antmicro/oculink-10gbe-adapter/2xrj45.kicad_sch

## KiCad design 2xrj45.kicad_sch (2026-02-23, an earlier design)

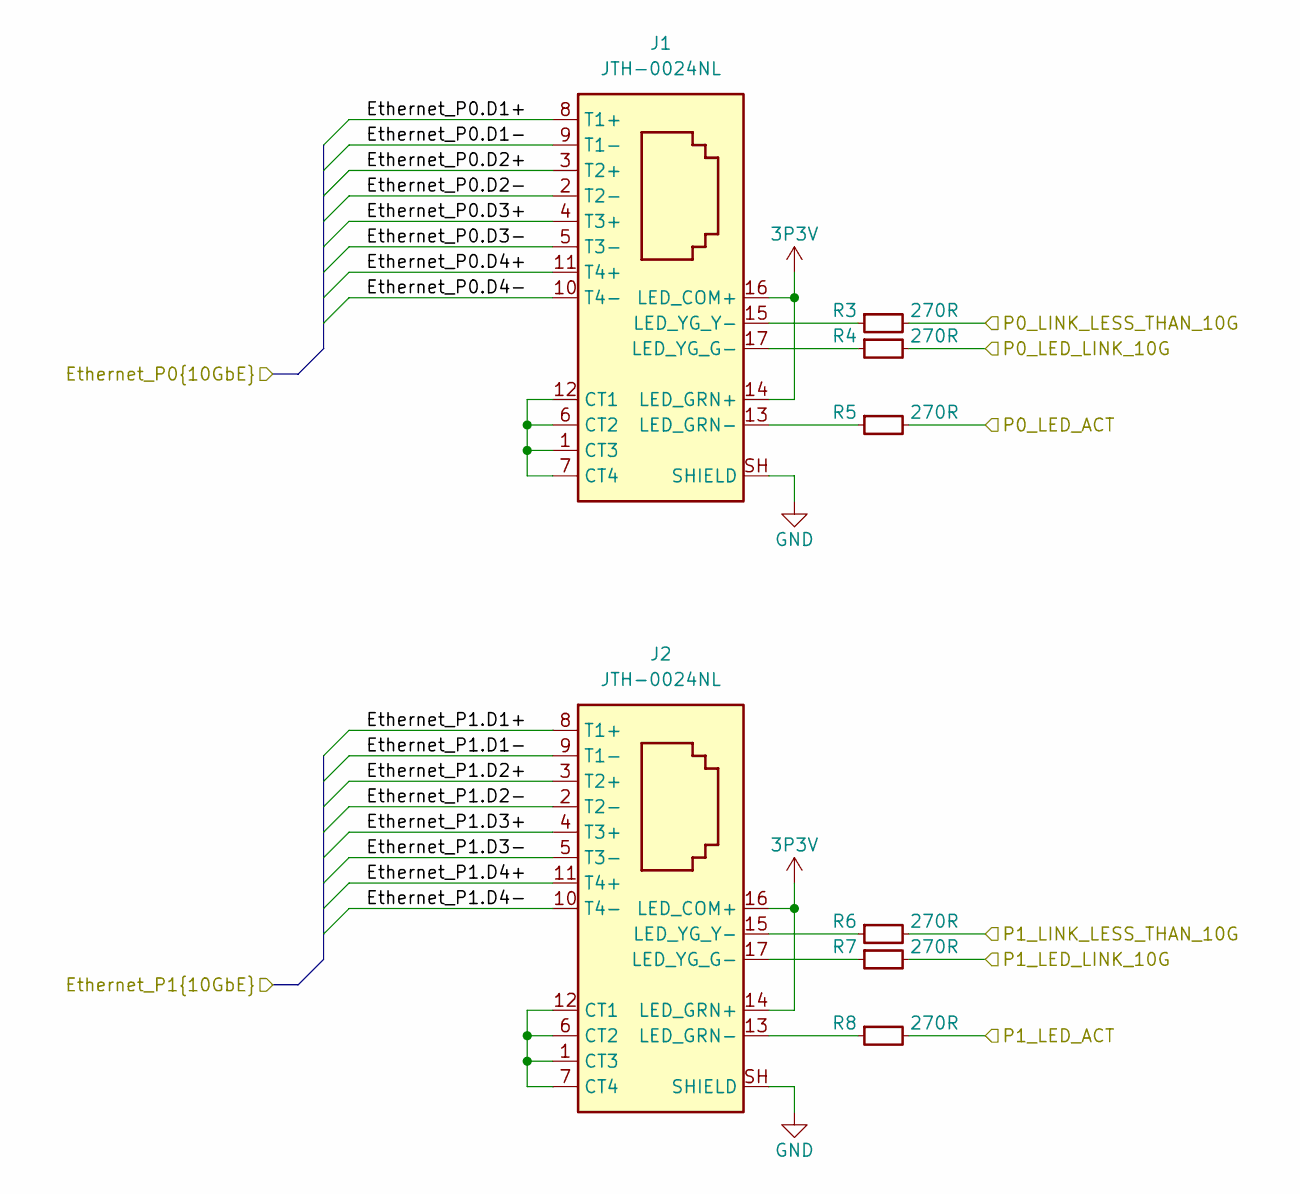
[picture p1: schematic 2xrj45.kicad_sch]

Parts:
J1, J2: Bus_RJ45_JTH-0024NL; RJ45_JTH-0024NL; MPN JTH-0024NL
R3, R4, R5, R6, R7, R8: R_270R_0402; R_0402_1005Metric; Tolerance 1%; MPN CR0402-FX-2700GLF

Connections:
3P3V: J1.14 (LED_GRN+), J1.16 (LED_COM+), J2.14 (LED_GRN+), J2.16 (LED_COM+)
Ethernet_P0.D1+: J1.8 (T1+)
Ethernet_P0.D1-: J1.9 (T1-)
Ethernet_P0.D2+: J1.3 (T2+)
Ethernet_P0.D2-: J1.2 (T2-)
Ethernet_P0.D3+: J1.4 (T3+)
Ethernet_P0.D3-: J1.5 (T3-)
Ethernet_P0.D4+: J1.11 (T4+)
Ethernet_P0.D4-: J1.10 (T4-)
Ethernet_P1.D1+: J2.8 (T1+)
Ethernet_P1.D1-: J2.9 (T1-)
Ethernet_P1.D2+: J2.3 (T2+)
Ethernet_P1.D2-: J2.2 (T2-)
Ethernet_P1.D3+: J2.4 (T3+)
Ethernet_P1.D3-: J2.5 (T3-)
Ethernet_P1.D4+: J2.11 (T4+)
Ethernet_P1.D4-: J2.10 (T4-)
GND: J1.SH (SHIELD), J2.SH (SHIELD)
unnamed: J1.1 (CT3), J1.6 (CT2), J1.7 (CT4), J1.12 (CT1)
unnamed: J1.13 (LED_GRN-), R5.1
unnamed: J1.15 (LED_YG_Y-), R3.1
unnamed: J1.17 (LED_YG_G-), R4.1
unnamed: J2.1 (CT3), J2.6 (CT2), J2.7 (CT4), J2.12 (CT1)
unnamed: J2.13 (LED_GRN-), R8.1
unnamed: J2.15 (LED_YG_Y-), R6.1
unnamed: J2.17 (LED_YG_G-), R7.1
P0_LED_ACT: R5.2
P0_LED_LINK_10G: R4.2
P0_LINK_LESS_THAN_10G: R3.2
P1_LED_ACT: R8.2
P1_LED_LINK_10G: R7.2
P1_LINK_LESS_THAN_10G: R6.2
