antmicro/oculink-10gbe-adapter/fan-controller.kicad_sch

## KiCad design fan-controller.kicad_sch (2026-02-23, an earlier design)

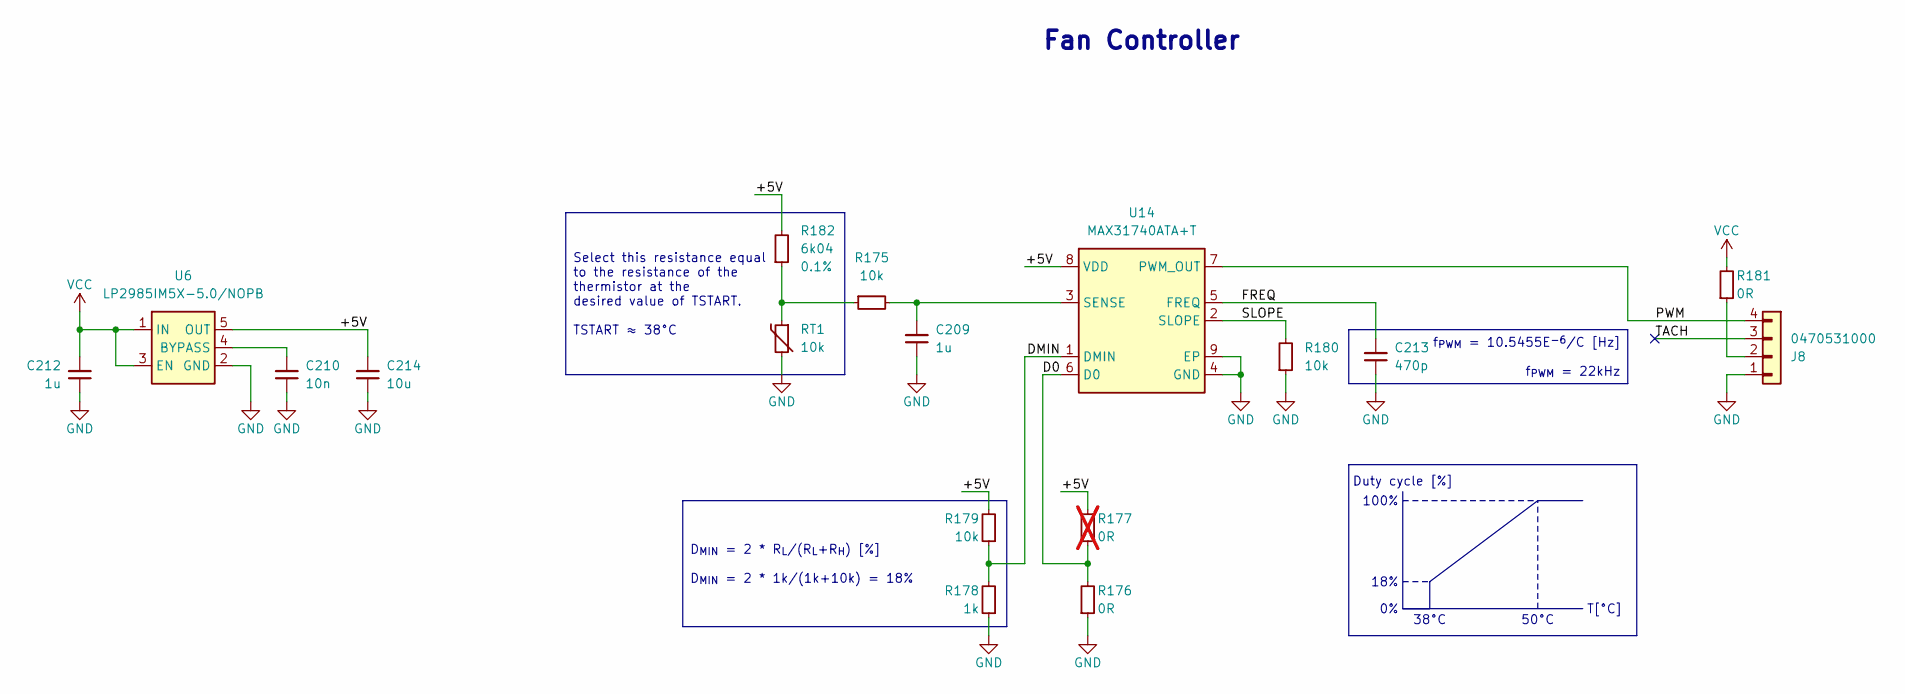
[picture p2: schematic fan-controller.kicad_sch]

Parts:
C209: C_1u_0402; C_0402_1005Metric; MPN C1005X6S1A105K050BC
C210: C_10n_0402; C_0402_1005Metric; Voltage 50V; MPN GRM155R71H103KA88D
C212: C_1u_16V_X7R_0603; C_0603_1608Metric; Voltage 16V; MPN C0603C105K4RAC7411
C213: C_470p_0402; C_0402_1005Metric; Voltage 25V; MPN 0402B471K250CT
C214: C_10u_10V_X7R_0603; C_0603_1608Metric; Voltage 10V; MPN GRM188Z71A106KA73D
J8: Molex_KK_1x4_0470531000; Conn_Molex_KK_1x4_0470531000; MPN 0470531000
R175, R179, R180: R_10k_0402; R_0402_1005Metric; Tolerance 1%; MPN CR0402-FX-1002GLF
R176, R181: R_0R_0402; R_0402_1005Metric; MPN ERJ2GE0R00X
R177: R_0R_0402; R_0402_1005Metric; MPN ERJ2GE0R00X; not fitted
R178: R_1k_0402; R_0402_1005Metric; Tolerance 1%; MPN CR0402-FX-1001GLF
R182: R_6k04_0.1%_0402; R_0402_1005Metric; Tolerance 0.1%; MPN TNPW04026K04BEED
RT1: RT_NTC_10k_0603; R_0603_1608Metric; Voltage 5V; MPN NCP15XH103F03RC
U6: LP2985IM5X-5.0_SOT; SOT-23-5; MPN LP2985IM5X-5.0/NOPB
U14: MAX31740ATA+T; TDFN-8-1EP_2x3x0.75mm_P0.5mm_EP1.75x1.63mm; MPN MAX31740ATA+T

Connections:
+5V: C214.2, R177.2, R179.2, R182.2, U6.5 (OUT), U14.8 (VDD)
D0: R176.2, R177.1, U14.6 (D0)
DMIN: R178.2, R179.1, U14.1 (DMIN)
FREQ: C213.2, U14.5 (FREQ)
GND: C209.1, C210.1, C212.1, C213.1, C214.1, J8.1, R176.1, R178.1, R180.1, RT1.2, U6.2 (GND), U14.4 (GND), U14.9 (EP)
unnamed: C209.2, R175.2, U14.3 (SENSE)
unnamed: C210.2, U6.4 (BYPASS)
unnamed: J8.2, R181.1
unnamed: R175.1, R182.1, RT1.1
PWM: J8.4, U14.7 (PWM_OUT)
SLOPE: R180.2, U14.2 (SLOPE)
TACH: J8.3
VCC: C212.2, R181.2, U6.1 (IN), U6.3 (EN)

Notes on the sheet:
Fan Controller
100%
Duty cycle [%]
T[°C]
38°C
50°C
18%
Select this resistance equal to the resistance of the thermistor at the desired value of TSTART. TSTART ≈ 38°C
D_{MIN} = 2 * R_{L}/(R_{L}+R_{H}) [%] D_{MIN} = 2 * 1k/(1k+10k) = 18%
f_{PWM} = 10.5455E^{-6}/C [Hz] f_{PWM} = 22kHz
