antmicro/oculink-10gbe-adapter/flash-memory.kicad_sch

## KiCad design flash-memory.kicad_sch (2026-02-23, an earlier design)

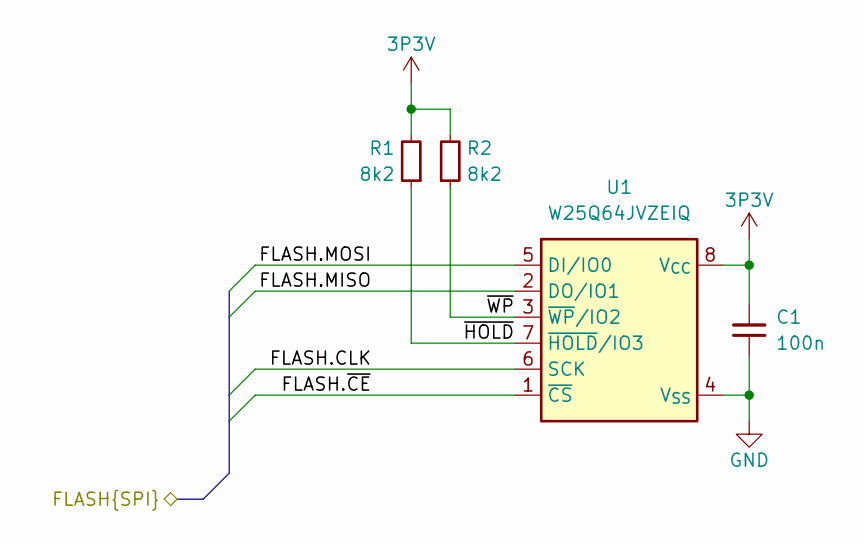
[picture p3: schematic flash-memory.kicad_sch]

Parts:
C1: C_100n_16V_X7R_0402; C_0402_1005Metric; Voltage 16V; MPN C0402C104J4RAC7411
R1, R2: R_8k2_0402; R_0402_1005Metric; Tolerance 1%; MPN CR0402-FX-8201GLF
U1: W25Q64JVZEIQ; WSON-8_6x8x0.5mm_P1.27mm; MPN W25Q64JVZEIQ

Connections:
3P3V: C1.2, R1.2, R2.2, U1.8 (V_{CC})
FLASH.CLK: U1.6 (SCK)
FLASH.MISO: U1.2 (DO/IO1)
FLASH.MOSI: U1.5 (DI/IO0)
FLASH.~CE: U1.1 (~CS)
GND: C1.1, U1.4 (V_{SS})
~HOLD: R1.1, U1.7 (~HOLD/IO3)
~WP: R2.1, U1.3 (~WP/IO2)
