antmicro/oculink-10gbe-adapter/ideal-diode.kicad_sch

## KiCad design ideal-diode.kicad_sch (2026-02-24, an earlier design)

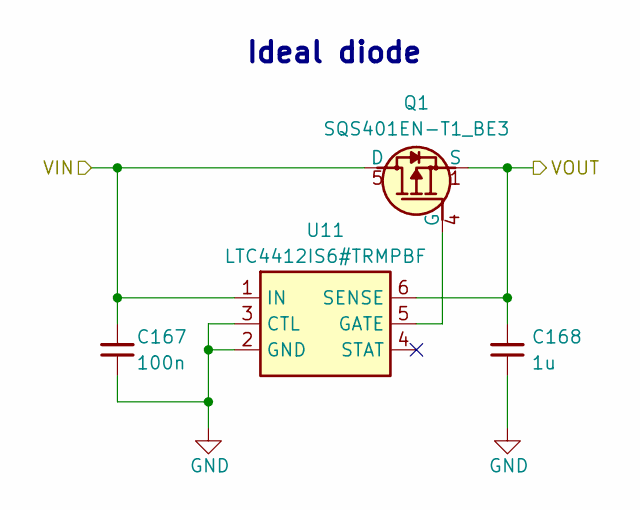
[picture p4: schematic ideal-diode.kicad_sch]

Parts:
C167: C_100n_0402; C_0402_1005Metric; Voltage 50V; MPN GRM155R61H104KE14D
C168: C_1u_25V_0402; C_0402_1005Metric; Voltage 25V; MPN GRM155R61E105KE11J
Q1: SQS401EN-T1_BE3; Vishay_PowerPAK_1212-8_Single; MPN SQS401EN-T1_BE3
U11: LTC4412IS6; SOT-23-6; MPN LTC4412IS6#TRMPBF

Connections:
GND: C167.1, C168.1, U11.2 (GND), U11.3 (CTL)
unnamed: Q1.4 (G), U11.5 (GATE)
VIN: C167.2, Q1.5 (D), U11.1 (IN)
VOUT: C168.2, Q1.1 (S), Q1.2 (S), Q1.3 (S), U11.6 (SENSE)

Notes on the sheet:
Ideal diode
