antmicro/oculink-10gbe-adapter/oculink-to-10gbe-adapter.kicad_sch

## KiCad design oculink-to-10gbe-adapter.kicad_sch (2026-02-23, an earlier design)

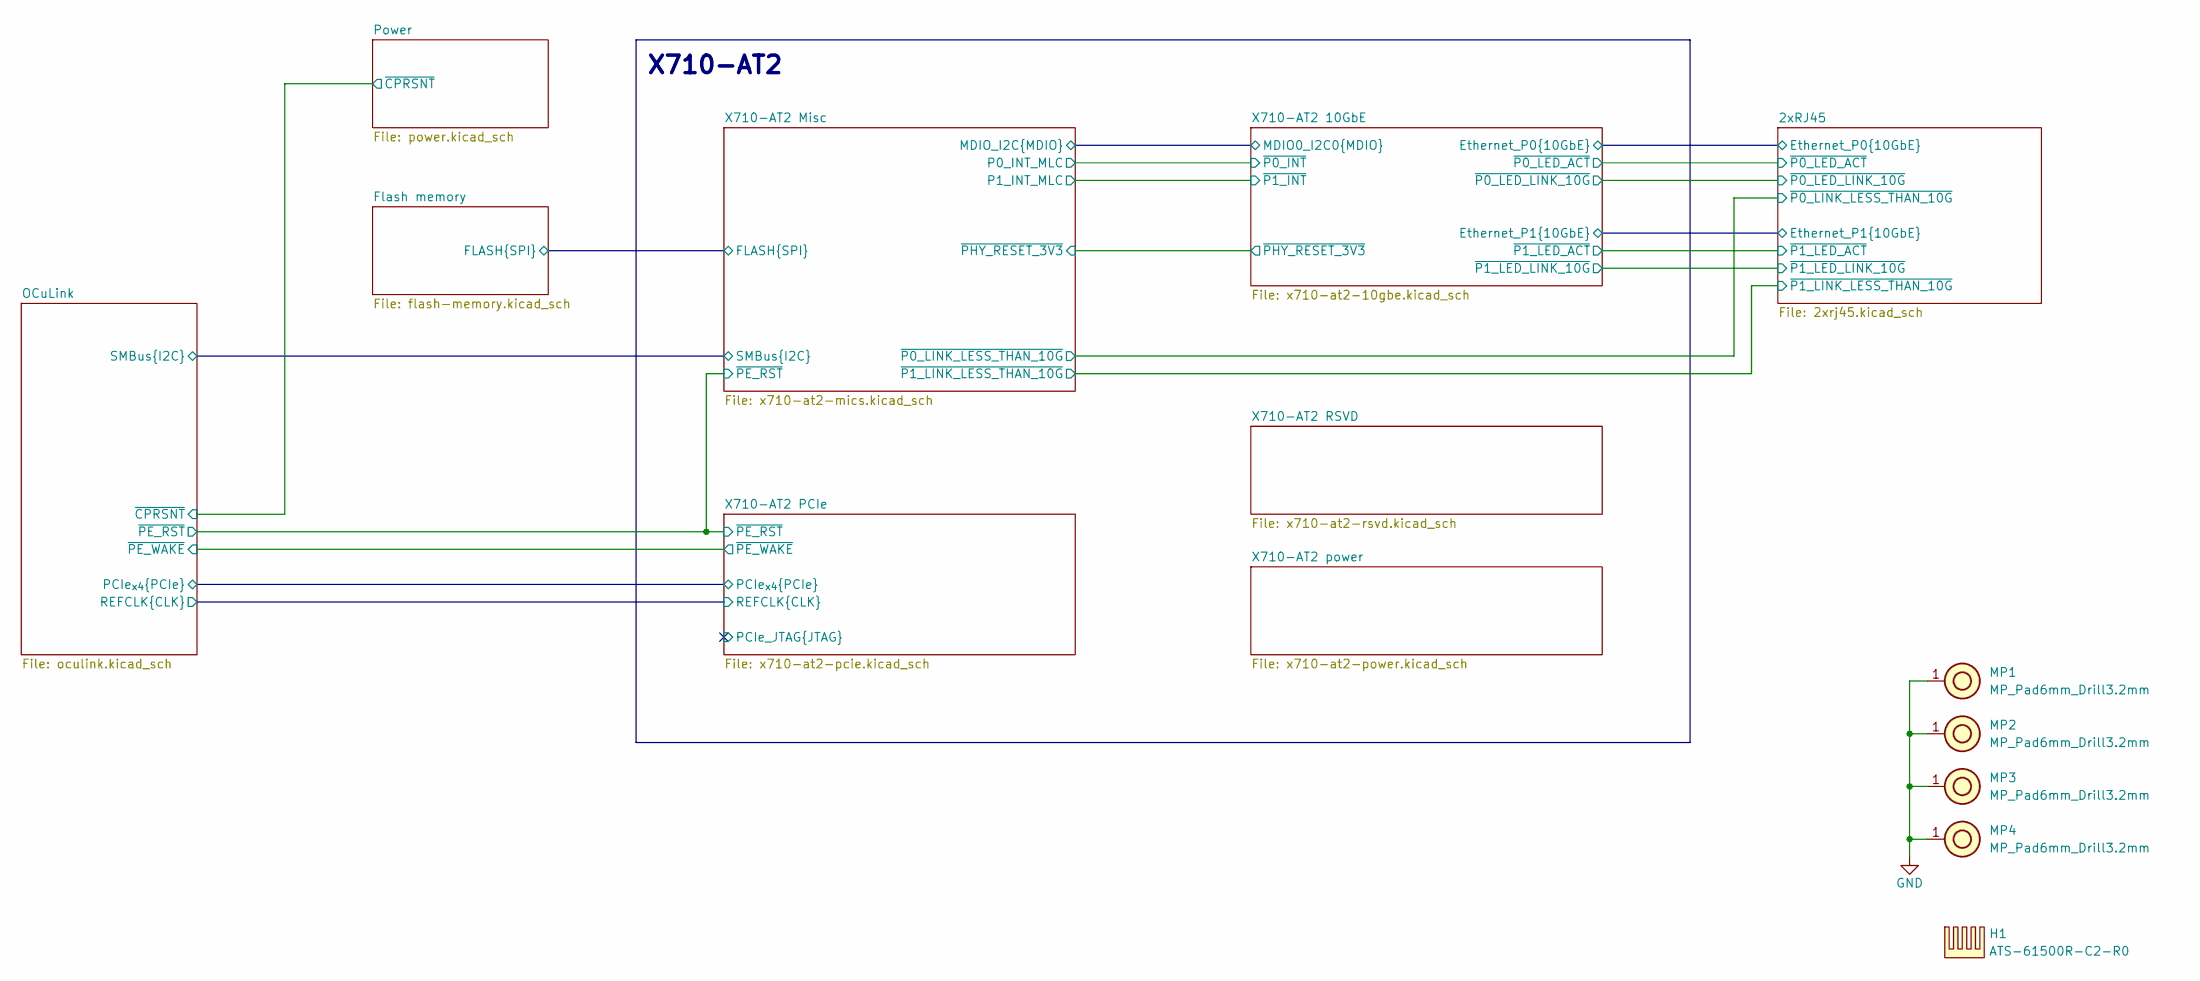
[picture p5: schematic oculink-to-10gbe-adapter.kicad_sch]

Parts:
H1: Heatsink_ATS-61500R-C2-R0; MPN ATS-61500R-C2-R0
MP1, MP2, MP3, MP4: MP_Pad6mm_Drill3.2mm

Connections:
GND: MP1.1, MP2.1, MP3.1, MP4.1

Notes on the sheet:
X710-AT2
