antmicro/oculink-10gbe-adapter/oculink.kicad_sch

## KiCad design oculink.kicad_sch (2026-02-23, an earlier design)

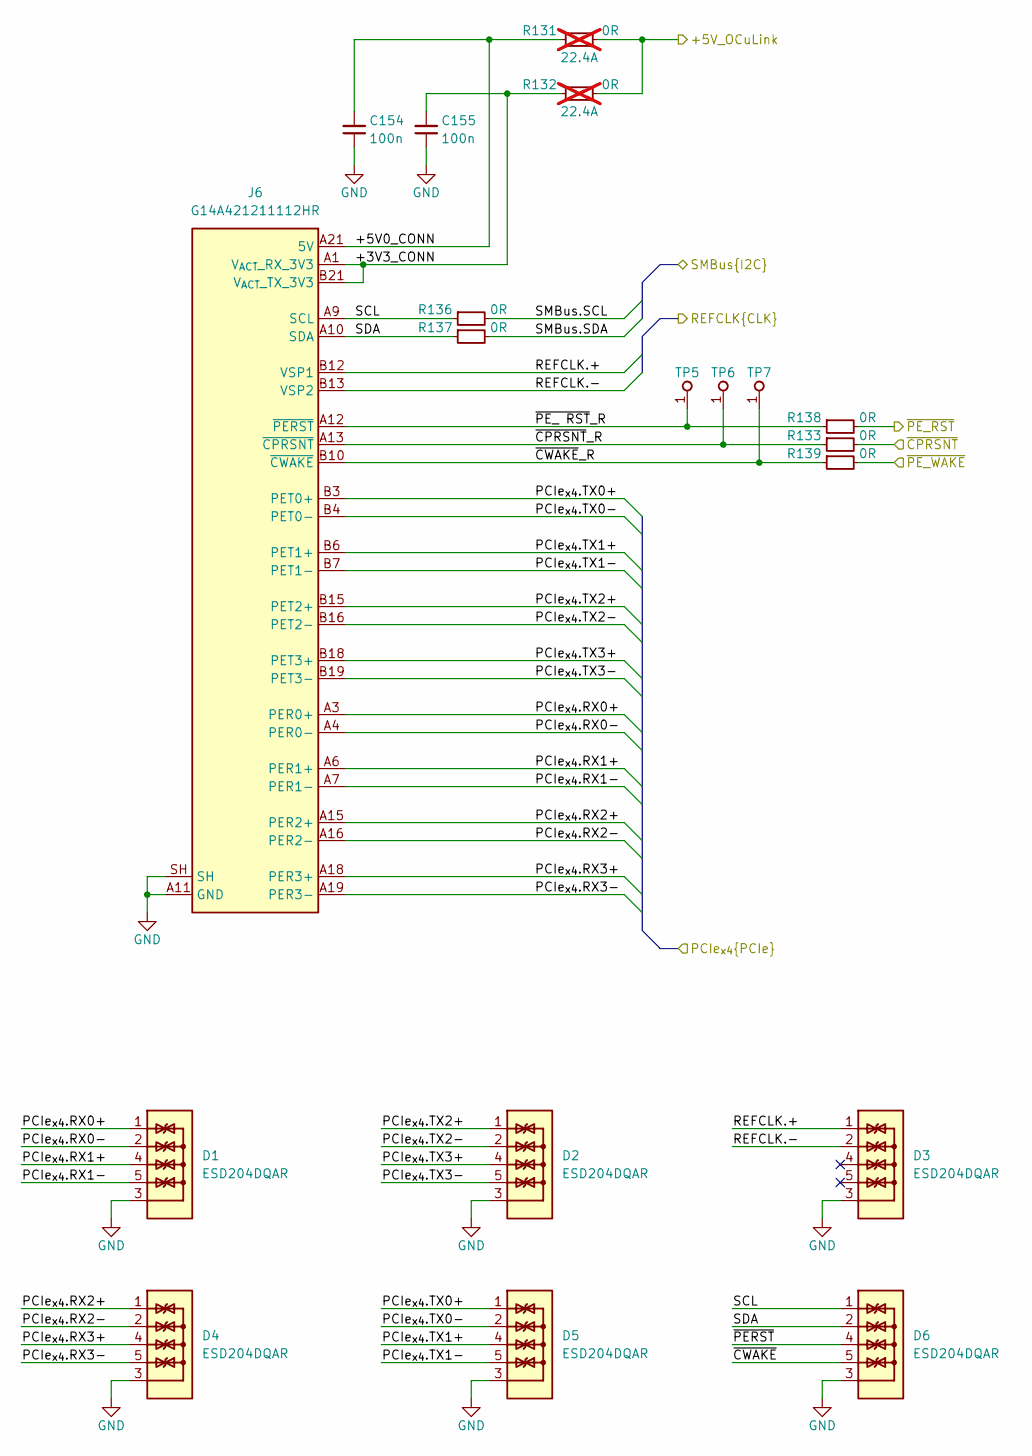
[picture p6: schematic oculink.kicad_sch]

Parts:
C154, C155: C_100n_16V_X7R_0402; C_0402_1005Metric; Voltage 16V; MPN C0402C104J4RAC7411
D1, D2, D3, D4, D5, D6: ESD204DQAR; USON-10_2.5x1mm_P0.5mm; MPN ESD204DQAR
J6: OCuLink_x4_Amphenol_G14A421211112HR_CUSTOM_device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; Amphenol_G14A421211112HR; MPN G14A421211112HR
R131, R132: R_0R_22.4A_0603; R_0603_1608Metric; Tolerance template_tolerance; MPN PMR03EZPJ000; not fitted
R133, R136, R137, R138, R139: R_0R_0402; R_0402_1005Metric; MPN ERJ2GE0R00X
TP5, TP6, TP7: TP_0.75mm_SMD; TP_SMD_0.75mm

Connections:
+3V3_CONN: C155.2, J6.A1 (V_{ACT}_RX_3V3), J6.B21 (V_{ACT}_TX_3V3), R132.2
+5V0_CONN: C154.2, J6.A21 (5V), J6.B1 (5V), R131.2
+5V_OCuLink: R131.1, R132.1
GND: C154.1, C155.1, D1.3, D1.8, D2.3, D2.8, D3.3, D3.8, D4.3, D4.8, D5.3, D5.8, D6.3, D6.8, J6.A2 (GND), J6.A5 (GND), J6.A8 (GND), J6.A11 (GND), J6.A14 (GND), J6.A17 (GND), J6.A20 (GND), J6.B2 (GND), J6.B5 (GND), J6.B8 (GND), J6.B11 (GND), J6.B14 (GND), J6.B17 (GND), J6.B20 (GND), J6.SH
unnamed: D3.4, D3.7
unnamed: D3.5, D3.6
PCIe_{x4}.RX0+: D1.1, D1.10, J6.A3 (PER0+)
PCIe_{x4}.RX0-: D1.2, D1.9, J6.A4 (PER0-)
PCIe_{x4}.RX1+: D1.4, D1.7, J6.A6 (PER1+)
PCIe_{x4}.RX1-: D1.5, D1.6, J6.A7 (PER1-)
PCIe_{x4}.RX2+: D4.1, D4.10, J6.A15 (PER2+)
PCIe_{x4}.RX2-: D4.2, D4.9, J6.A16 (PER2-)
PCIe_{x4}.RX3+: D4.4, D4.7, J6.A18 (PER3+)
PCIe_{x4}.RX3-: D4.5, D4.6, J6.A19 (PER3-)
PCIe_{x4}.TX0+: D5.1, D5.10, J6.B3 (PET0+)
PCIe_{x4}.TX0-: D5.2, D5.9, J6.B4 (PET0-)
PCIe_{x4}.TX1+: D5.4, D5.7, J6.B6 (PET1+)
PCIe_{x4}.TX1-: D5.5, D5.6, J6.B7 (PET1-)
PCIe_{x4}.TX2+: D2.1, D2.10, J6.B15 (PET2+)
PCIe_{x4}.TX2-: D2.2, D2.9, J6.B16 (PET2-)
PCIe_{x4}.TX3+: D2.4, D2.7, J6.B18 (PET3+)
PCIe_{x4}.TX3-: D2.5, D2.6, J6.B19 (PET3-)
REFCLK.+: D3.1, D3.10, J6.B12 (VSP1)
REFCLK.-: D3.2, D3.9, J6.B13 (VSP2)
SCL: D6.1, D6.10, J6.A9 (SCL), R136.1
SDA: D6.2, D6.9, J6.A10 (SDA), R137.1
SMBus.SCL: R136.2
SMBus.SDA: R137.2
~CPRSNT: R133.2
~CPRSNT_R: J6.A13 (~CPRSNT), R133.1, TP6.1
~CWAKE: D6.5, D6.6
~CWAKE_R: J6.B10 (~CWAKE), R139.1, TP7.1
~PERST: D6.4, D6.7
~PE_ RST_R: J6.A12 (~PERST), R138.1, TP5.1
~PE_RST: R138.2
~PE_WAKE: R139.2
