antmicro/oculink-10gbe-adapter/x710-at2-10gbe.kicad_sch

## KiCad design x710-at2-10gbe.kicad_sch (2026-02-23, an earlier design)

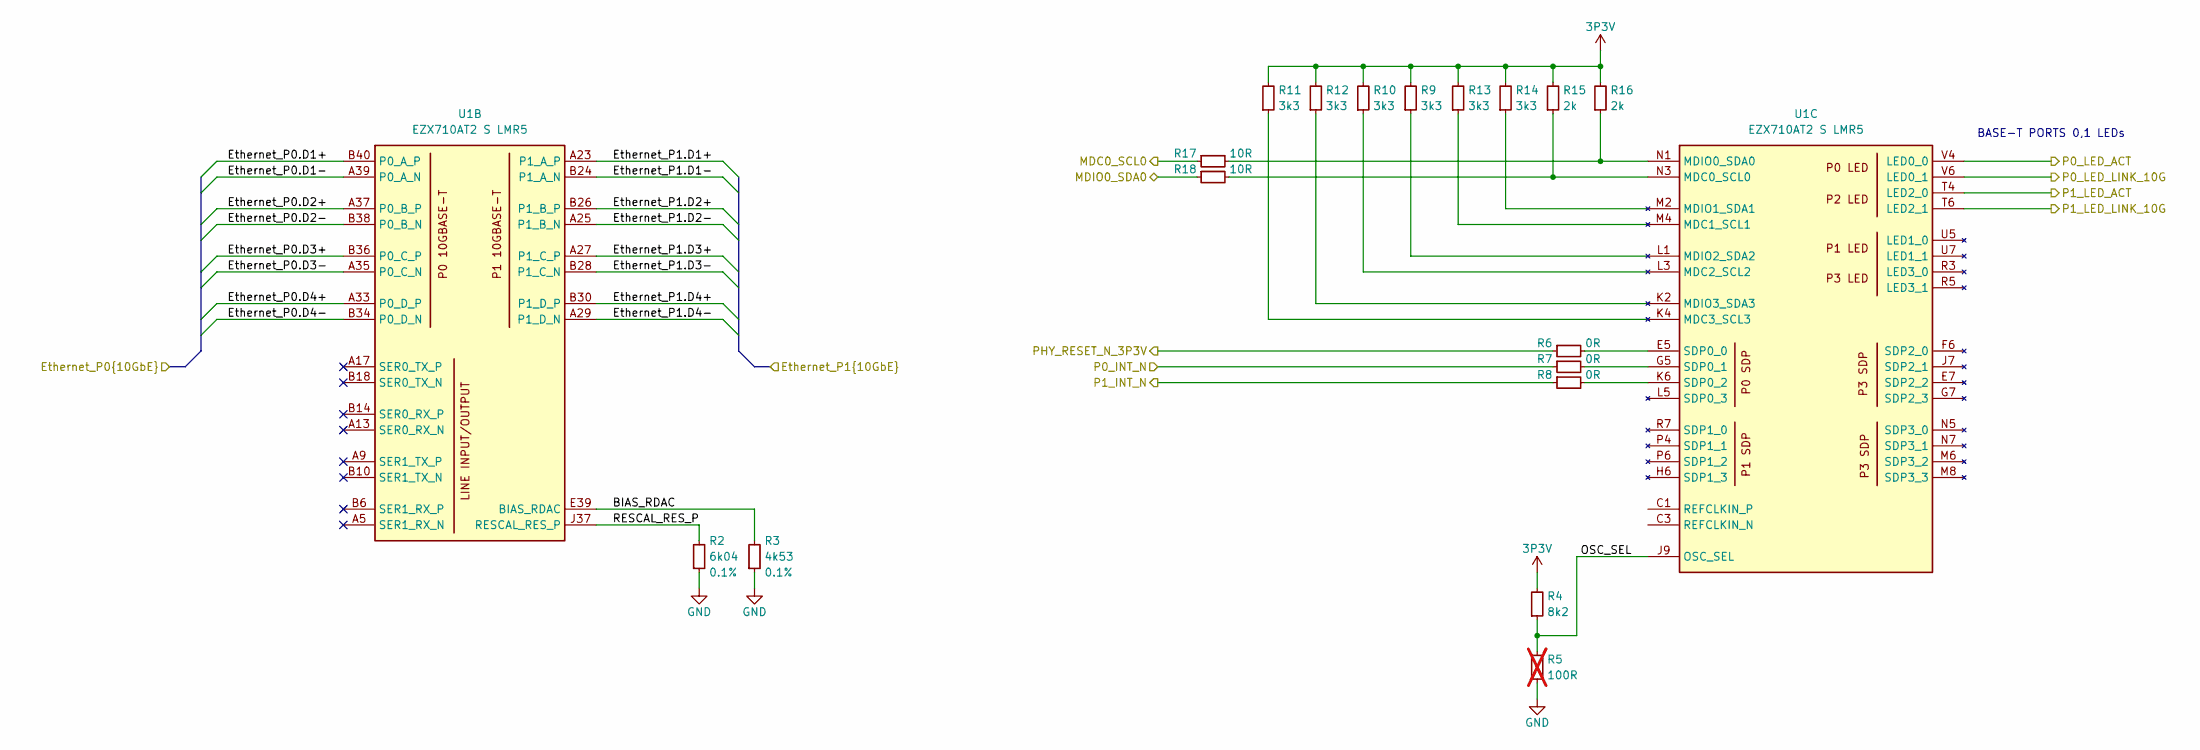
[picture p7: schematic x710-at2-10gbe.kicad_sch]

Parts:
R2: R_6k04_0.1%_0402; R_0402_1005Metric; Tolerance 0.1%; MPN TNPW04026K04BEED
R3: R_4k53_0402; R_0402_1005Metric; Tolerance 0.1%; MPN ERA-2AEB4531X
R4: R_8k2_0402; R_0402_1005Metric; Tolerance 1%; MPN CR0402-FX-8201GLF
R5: R_100R_0402; R_0402_1005Metric; Tolerance 1%; MPN CR0402-FX-1000GLF; not fitted
R6, R7, R8: R_0R_0402; R_0402_1005Metric; MPN ERJ2GE0R00X
R9, R10, R11, R12, R13, R14: R_3k3_0402; R_0402_1005Metric; Tolerance 1%; MPN CR0402-FX-3301GLF
R15, R16: R_2k_0402; R_0402_1005Metric; Tolerance 1%; MPN CR0402-FX-2001GLF
R17, R18: R_10R_0402; R_0402_1005Metric; Tolerance 1%; MPN CR0402-FX-10R0GLF
U1: EZX710AT2_S_LMR5; FCBGA-503_22x22mm_Layout21x24_P1mm; MPN EZX710AT2 S LMR5

Connections:
3P3V: R4.2, R9.2, R10.2, R11.2, R12.2, R13.2, R14.2, R15.2, R16.2
BIAS_RDAC: R3.2, U1.E39 (BIAS_RDAC)
Ethernet_P0.D1+: U1.B40 (P0_A_P)
Ethernet_P0.D1-: U1.A39 (P0_A_N)
Ethernet_P0.D2+: U1.A37 (P0_B_P)
Ethernet_P0.D2-: U1.B38 (P0_B_N)
Ethernet_P0.D3+: U1.B36 (P0_C_P)
Ethernet_P0.D3-: U1.A35 (P0_C_N)
Ethernet_P0.D4+: U1.A33 (P0_D_P)
Ethernet_P0.D4-: U1.B34 (P0_D_N)
Ethernet_P1.D1+: U1.A23 (P1_A_P)
Ethernet_P1.D1-: U1.B24 (P1_A_N)
Ethernet_P1.D2+: U1.B26 (P1_B_P)
Ethernet_P1.D2-: U1.A25 (P1_B_N)
Ethernet_P1.D3+: U1.A27 (P1_C_P)
Ethernet_P1.D3-: U1.B28 (P1_C_N)
Ethernet_P1.D4+: U1.B30 (P1_D_P)
Ethernet_P1.D4-: U1.A29 (P1_D_N)
GND: R2.1, R3.1, R5.1
MDC0_SCL0: R17.1
MDIO0_SDA0: R18.1
unnamed: R6.2, U1.E5 (SDP0_0)
unnamed: R7.2, U1.G5 (SDP0_1)
unnamed: R8.2, U1.K6 (SDP0_2)
unnamed: R9.1, U1.L1 (MDIO2_SDA2)
unnamed: R10.1, U1.L3 (MDC2_SCL2)
unnamed: R11.1, U1.K4 (MDC3_SCL3)
unnamed: R12.1, U1.K2 (MDIO3_SDA3)
unnamed: R13.1, U1.M4 (MDC1_SCL1)
unnamed: R14.1, U1.M2 (MDIO1_SDA1)
unnamed: R15.1, R18.2, U1.N3 (MDC0_SCL0)
unnamed: R16.1, R17.2, U1.N1 (MDIO0_SDA0)
OSC_SEL: R4.1, R5.2, U1.J9 (OSC_SEL)
P0_INT_N: R7.1
P0_LED_ACT: U1.V4 (LED0_0)
P0_LED_LINK_10G: U1.V6 (LED0_1)
P1_INT_N: R8.1
P1_LED_ACT: U1.T4 (LED2_0)
P1_LED_LINK_10G: U1.T6 (LED2_1)
PHY_RESET_N_3P3V: R6.1
RESCAL_RES_P: R2.2, U1.J37 (RESCAL_RES_P)

Notes on the sheet:
BASE-T PORTS 0,1 LEDs
