antmicro/oculink-10gbe-adapter/x710-at2-mics.kicad_sch

## KiCad design x710-at2-mics.kicad_sch (2026-02-23, an earlier design)

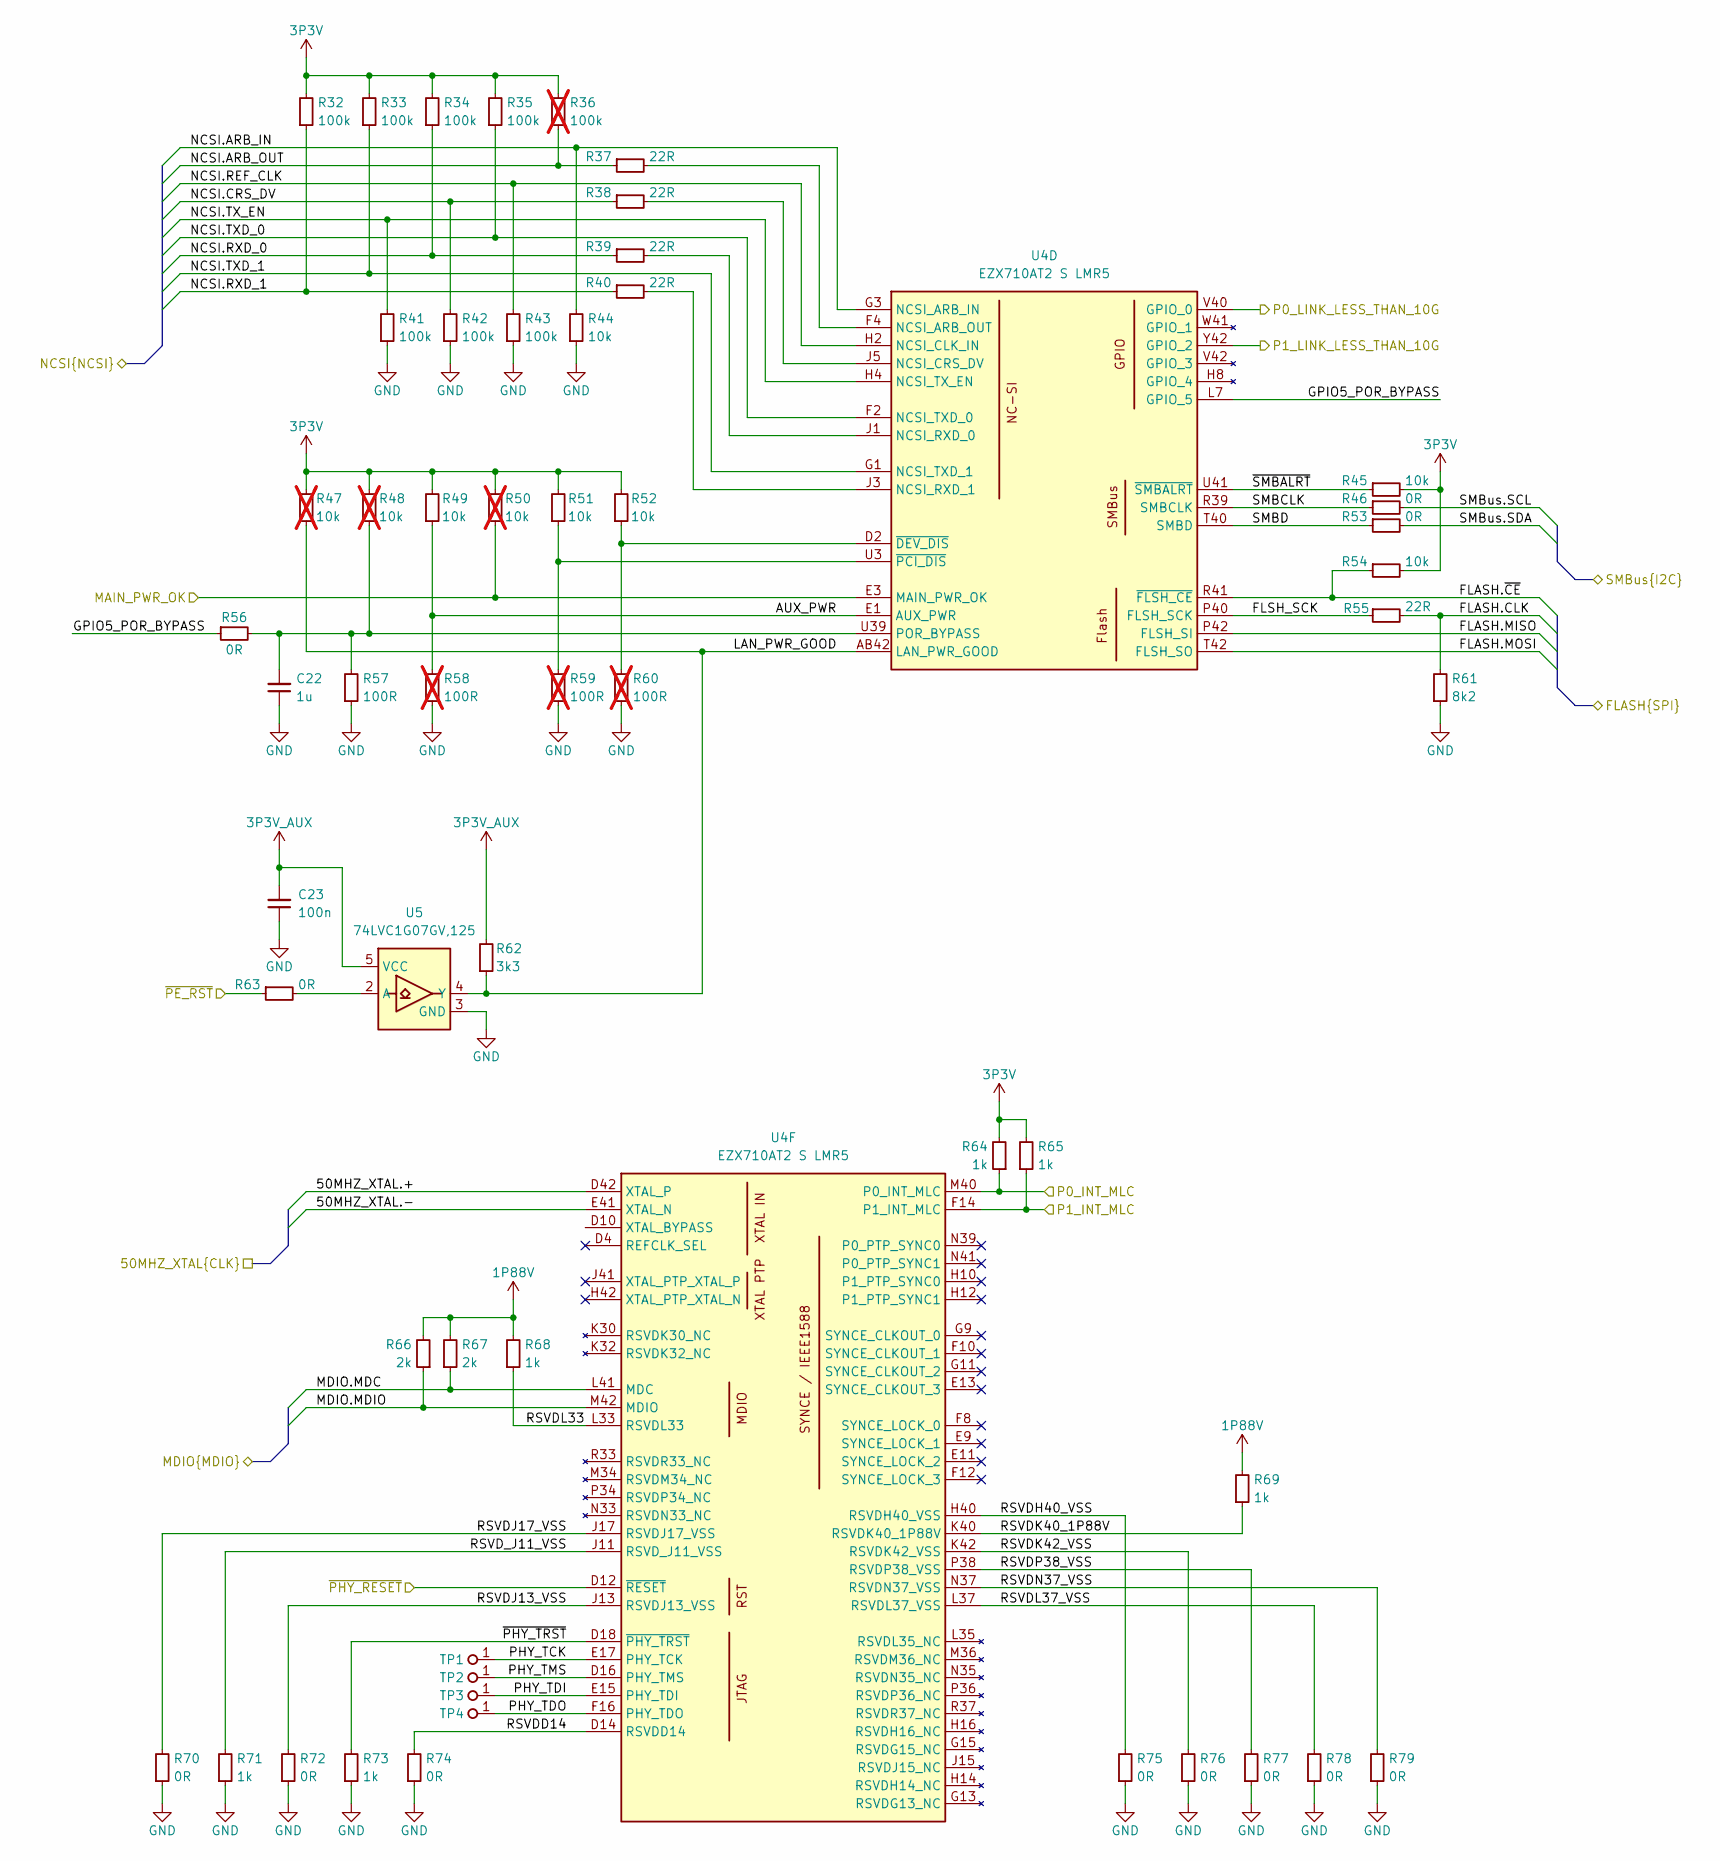
[picture p8: schematic x710-at2-mics.kicad_sch]

Parts:
C22: C_1u_16V_X7R_0603; C_0603_1608Metric; Voltage 16V; MPN C0603C105K4RAC7411
C23: C_100n_16V_X7R_0402; C_0402_1005Metric; Voltage 16V; MPN C0402C104J4RAC7411
R32, R33, R34, R35, R41, R42, R43: R_100k_0402; R_0402_1005Metric; Tolerance 1%; MPN CR0402-FX-1003GLF
R36: R_100k_0402; R_0402_1005Metric; Tolerance 1%; MPN CR0402-FX-1003GLF; not fitted
R37, R38, R39, R40, R55: R_22R_0402; R_0402_1005Metric; Tolerance 1%; MPN CR0402-FX-22R0GLF
R44, R45, R49, R51, R52, R54: R_10k_0402; R_0402_1005Metric; Tolerance 1%; MPN CR0402-FX-1002GLF
R46, R53, R56, R63, R70, R72, R74, R75, R76, R77, R78, R79: R_0R_0402; R_0402_1005Metric; MPN ERJ2GE0R00X
R47, R48, R50: R_10k_0402; R_0402_1005Metric; Tolerance 1%; MPN CR0402-FX-1002GLF; not fitted
R57: R_100R_0402; R_0402_1005Metric; Tolerance 1%; MPN CR0402-FX-1000GLF
R58, R59, R60: R_100R_0402; R_0402_1005Metric; Tolerance 1%; MPN CR0402-FX-1000GLF; not fitted
R61: R_8k2_0402; R_0402_1005Metric; Tolerance 1%; MPN CR0402-FX-8201GLF
R62: R_3k3_0402; R_0402_1005Metric; Tolerance 1%; MPN CR0402-FX-3301GLF
R64, R65, R68, R69, R71, R73: R_1k_0402; R_0402_1005Metric; Tolerance 1%; MPN CR0402-FX-1001GLF
R66, R67: R_2k_0402; R_0402_1005Metric; Tolerance 1%; MPN CR0402-FX-2001GLF
TP1, TP2, TP3, TP4: TP_0.75mm_SMD; TP_SMD_0.75mm
U4: EZX710AT2_S_LMR5; FCBGA-503_22x22mm_Layout21x24_P1mm; MPN EZX710AT2 S LMR5
U5: 74LVC1G07_SOT-753; SOT-753; MPN 74LVC1G07GV,125

Connections:
1P88V: R66.2, R67.2, R68.2, R69.2
3P3V: R32.2, R33.2, R34.2, R35.2, R36.2, R45.2, R47.2, R48.2, R49.2, R50.2, R51.2, R52.2, R54.2, R64.2, R65.2
3P3V_AUX: C23.2, R62.2, U5.5 (VCC)
50MHZ_XTAL.+: U4.D42 (XTAL_P)
50MHZ_XTAL.-: U4.E41 (XTAL_N)
AUX_PWR: R49.1, R58.2, U4.E1 (AUX_PWR)
FLASH.CLK: R55.2, R61.2
FLASH.MISO: U4.P42 (FLSH_SI)
FLASH.MOSI: U4.T42 (FLSH_SO)
FLASH.~CE: R54.1, U4.R41 (~FLSH_CE)
FLSH_SCK: R55.1, U4.P40 (FLSH_SCK)
GND: C22.1, C23.1, R41.1, R42.1, R43.1, R44.1, R57.1, R58.1, R59.1, R60.1, R61.1, R70.1, R71.1, R72.1, R73.1, R74.1, R75.1, R76.1, R77.1, R78.1, R79.1, U5.3 (GND)
GPIO5_POR_BYPASS: R56.1, U4.L7 (GPIO_5)
LAN_PWR_GOOD: R47.1, R62.1, U4.AB42 (LAN_PWR_GOOD), U5.4 (Y)
MAIN_PWR_OK: R50.1, U4.E3 (MAIN_PWR_OK)
MDIO.MDC: R67.1, U4.L41 (MDC)
MDIO.MDIO: R66.1, U4.M42 (MDIO)
NCSI.ARB_IN: R44.2, U4.G3 (NCSI_ARB_IN)
NCSI.ARB_OUT: R36.1, R37.1
NCSI.CRS_DV: R38.1, R42.2
NCSI.REF_CLK: R43.2, U4.H2 (NCSI_CLK_IN)
NCSI.RXD_0: R34.1, R39.1
NCSI.RXD_1: R32.1, R40.1
NCSI.TXD_0: R35.1, U4.F2 (NCSI_TXD_0)
NCSI.TXD_1: R33.1, U4.G1 (NCSI_TXD_1)
NCSI.TX_EN: R41.2, U4.H4 (NCSI_TX_EN)
unnamed: C22.2, R48.1, R56.2, R57.2, U4.U39 (POR_BYPASS)
unnamed: R37.2, U4.F4 (NCSI_ARB_OUT)
unnamed: R38.2, U4.J5 (NCSI_CRS_DV)
unnamed: R39.2, U4.J1 (NCSI_RXD_0)
unnamed: R40.2, U4.J3 (NCSI_RXD_1)
unnamed: R51.1, R59.2, U4.U3 (~PCI_DIS)
unnamed: R52.1, R60.2, U4.D2 (~DEV_DIS)
unnamed: R63.2, U5.2 (A)
P0_INT_MLC: R64.1, U4.M40 (P0_INT_MLC)
P0_LINK_LESS_THAN_10G: U4.V40 (GPIO_0)
P1_INT_MLC: R65.1, U4.F14 (P1_INT_MLC)
P1_LINK_LESS_THAN_10G: U4.Y42 (GPIO_2)
PHY_TCK: TP1.1, U4.E17 (PHY_TCK)
PHY_TDI: TP3.1, U4.E15 (PHY_TDI)
PHY_TDO: TP4.1, U4.F16 (PHY_TDO)
PHY_TMS: TP2.1, U4.D16 (PHY_TMS)
RSVDD14: R74.2, U4.D14 (RSVDD14)
RSVDH40_VSS: R75.2, U4.H40 (RSVDH40_VSS)
RSVDJ13_VSS: R72.2, U4.J13 (RSVDJ13_VSS)
RSVDJ17_VSS: R70.2, U4.J17 (RSVDJ17_VSS)
RSVDK40_1P88V: R69.1, U4.K40 (RSVDK40_1P88V)
RSVDK42_VSS: R76.2, U4.K42 (RSVDK42_VSS)
RSVDL33: R68.1, U4.L33 (RSVDL33)
RSVDL37_VSS: R78.2, U4.L37 (RSVDL37_VSS)
RSVDN37_VSS: R79.2, U4.N37 (RSVDN37_VSS)
RSVDP38_VSS: R77.2, U4.P38 (RSVDP38_VSS)
RSVD_J11_VSS: R71.2, U4.J11 (RSVD_J11_VSS)
SMBCLK: R46.1, U4.R39 (SMBCLK)
SMBD: R53.1, U4.T40 (SMBD)
SMBus.SCL: R46.2
SMBus.SDA: R53.2
~PE_RST: R63.1
~PHY_RESET: U4.D12 (~RESET)
~PHY_TRST: R73.2, U4.D18 (~PHY_TRST)
~SMBALRT: R45.1, U4.U41 (~SMBALRT)
