antmicro/oculink-10gbe-adapter/x710-at2-pcie.kicad_sch

## KiCad design x710-at2-pcie.kicad_sch (2026-02-23, an earlier design)

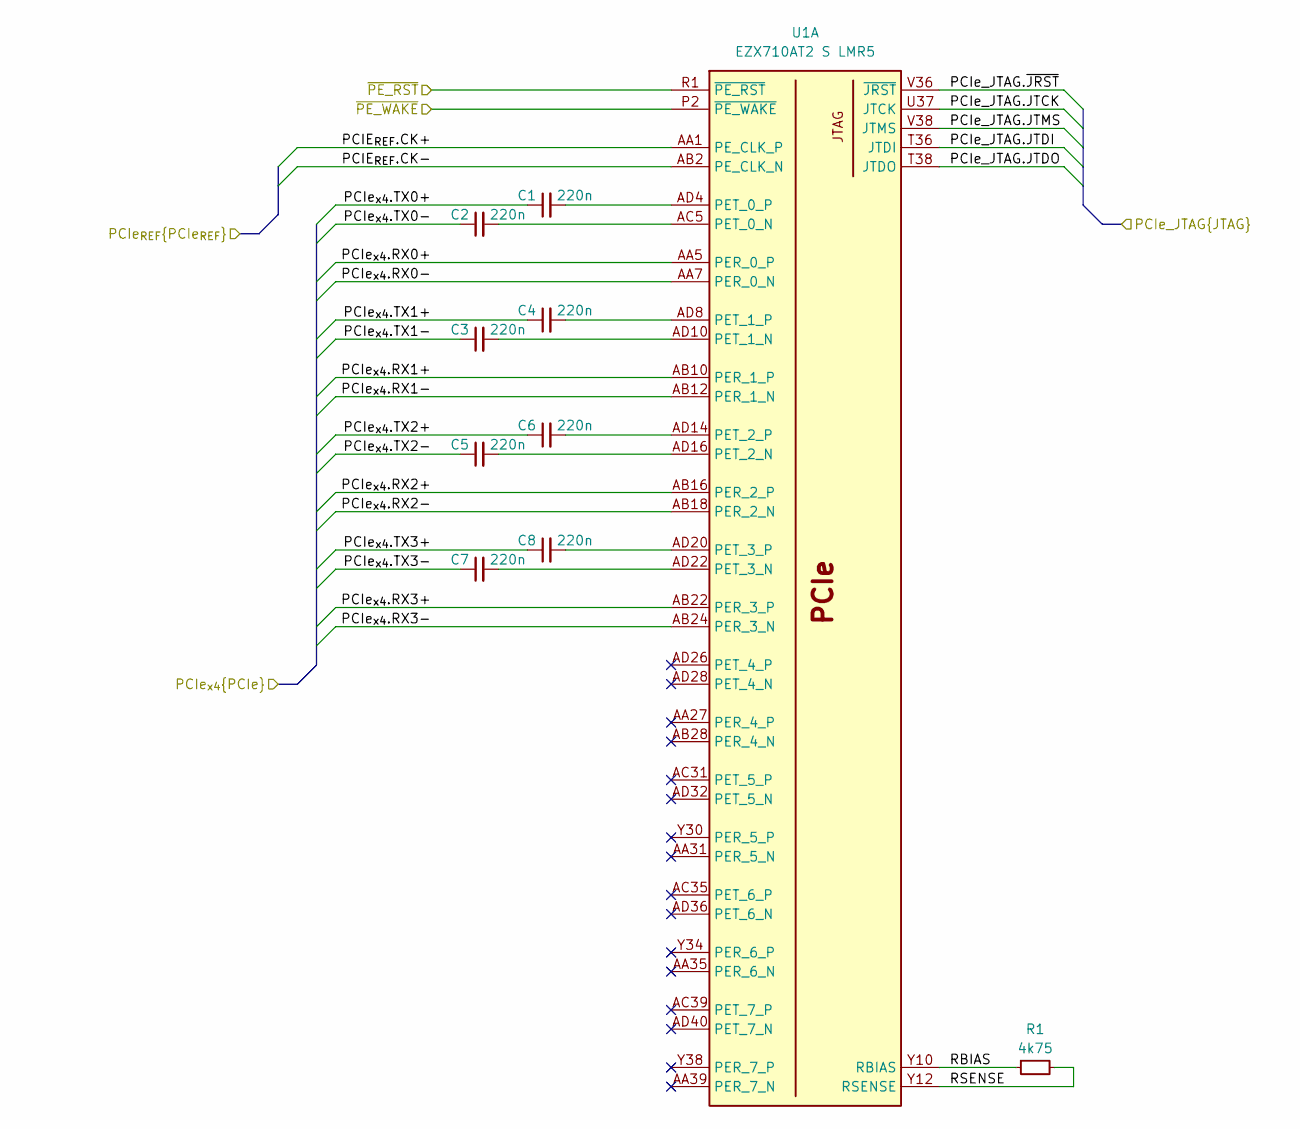
[picture p9: schematic x710-at2-pcie.kicad_sch]

Parts:
C1, C2, C3, C4, C5, C6, C7, C8: C_220n_16V_0402; C_0402_1005Metric; Voltage 16V; MPN GRM155R71C224KA12D
R1: R_4k75_0.5%_0402; R_0402_1005Metric; Tolerance 0.5%; MPN ERJ-H2RD4751X
U1: EZX710AT2_S_LMR5; FCBGA-503_22x22mm_Layout21x24_P1mm; MPN EZX710AT2 S LMR5

Connections:
unnamed: C1.2, U1.AD4 (PET_0_P)
unnamed: C2.2, U1.AC5 (PET_0_N)
unnamed: C3.2, U1.AD10 (PET_1_N)
unnamed: C4.2, U1.AD8 (PET_1_P)
unnamed: C5.2, U1.AD16 (PET_2_N)
unnamed: C6.2, U1.AD14 (PET_2_P)
unnamed: C7.2, U1.AD22 (PET_3_N)
unnamed: C8.2, U1.AD20 (PET_3_P)
PCIE_{REF}.CK+: U1.AA1 (PE_CLK_P)
PCIE_{REF}.CK-: U1.AB2 (PE_CLK_N)
PCIe_JTAG.JTCK: U1.U37 (JTCK)
PCIe_JTAG.JTDI: U1.T36 (JTDI)
PCIe_JTAG.JTDO: U1.T38 (JTDO)
PCIe_JTAG.JTMS: U1.V38 (JTMS)
PCIe_JTAG.~JRST: U1.V36 (~JRST)
PCIe_{x4}.RX0+: U1.AA5 (PER_0_P)
PCIe_{x4}.RX0-: U1.AA7 (PER_0_N)
PCIe_{x4}.RX1+: U1.AB10 (PER_1_P)
PCIe_{x4}.RX1-: U1.AB12 (PER_1_N)
PCIe_{x4}.RX2+: U1.AB16 (PER_2_P)
PCIe_{x4}.RX2-: U1.AB18 (PER_2_N)
PCIe_{x4}.RX3+: U1.AB22 (PER_3_P)
PCIe_{x4}.RX3-: U1.AB24 (PER_3_N)
PCIe_{x4}.TX0+: C1.1
PCIe_{x4}.TX0-: C2.1
PCIe_{x4}.TX1+: C4.1
PCIe_{x4}.TX1-: C3.1
PCIe_{x4}.TX2+: C6.1
PCIe_{x4}.TX2-: C5.1
PCIe_{x4}.TX3+: C8.1
PCIe_{x4}.TX3-: C7.1
RBIAS: R1.1, U1.Y10 (RBIAS)
RSENSE: R1.2, U1.Y12 (RSENSE)
~PE_RST: U1.R1 (~PE_RST)
~PE_WAKE: U1.P2 (~PE_WAKE)
