antmicro/oculink-10gbe-adapter/x710-at2-power.kicad_sch

## KiCad design x710-at2-power.kicad_sch (2026-02-23, an earlier design)

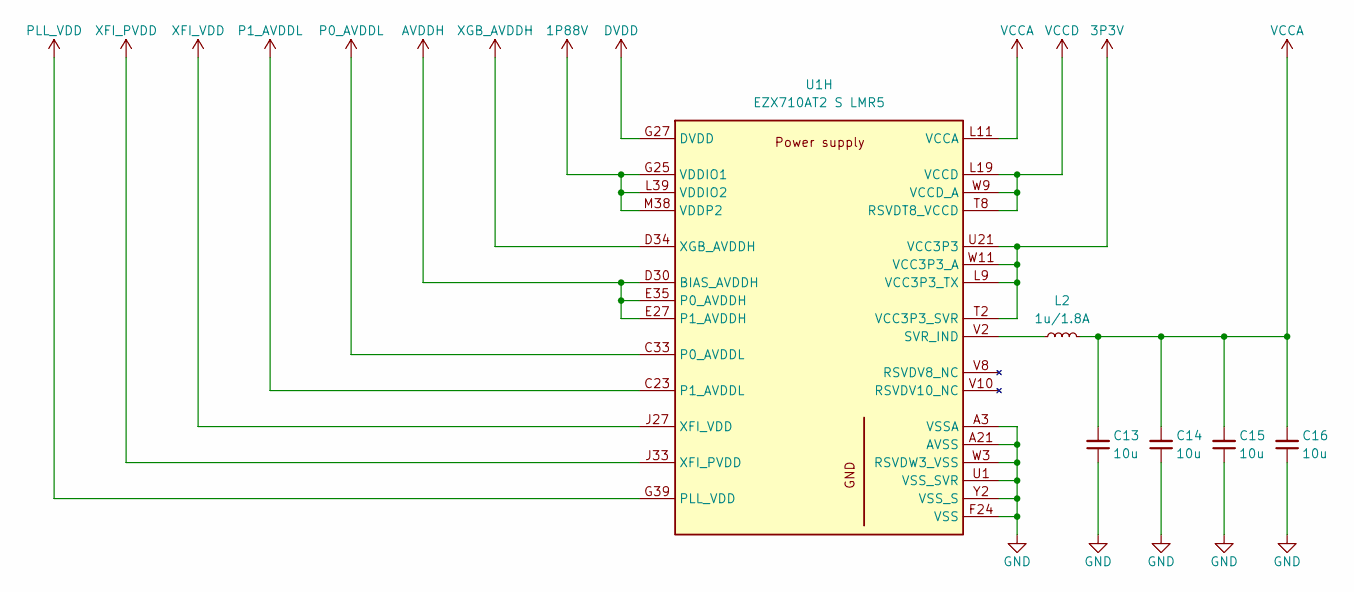
[picture p10: schematic x710-at2-power.kicad_sch]

Parts:
C13, C14, C15, C16: C_10u_10V_X7R_0603; C_0603_1608Metric; Voltage 10V; MPN GRM188Z71A106KA73D
L2: L_1u_1.8A_0603; L_0603_1608Metric; MPN DFE18SBN1R0ME0L
U1: EZX710AT2_S_LMR5; FCBGA-503_22x22mm_Layout21x24_P1mm; MPN EZX710AT2 S LMR5

Connections:
1P88V: U1.G25 (VDDIO1), U1.G37 (VDDIO1), U1.L39 (VDDIO2), U1.M38 (VDDP2)
3P3V: U1.L9 (VCC3P3_TX), U1.R11 (VCC3P3), U1.T2 (VCC3P3_SVR), U1.T34 (VCC3P3), U1.U21 (VCC3P3), U1.W11 (VCC3P3_A)
AVDDH: U1.D30 (BIAS_AVDDH), U1.E27 (P1_AVDDH), U1.E29 (P1_AVDDH), U1.E35 (P0_AVDDH), U1.E37 (P0_AVDDH)
DVDD: U1.G27 (DVDD), U1.G29 (DVDD), U1.G31 (DVDD), U1.G33 (DVDD), U1.G35 (DVDD)
GND: C13.1, C14.1, C15.1, C16.1, U1.A3 (VSSA), U1.A7 (VSSA), U1.A11 (VSSA), U1.A15 (VSSA), U1.A19 (VSSA), U1.A21 (AVSS), U1.A31 (AVSS), U1.AA3 (VSSA), U1.AA9 (VSSA), U1.AA11 (VSSA), U1.AA13 (VSSA), U1.AA15 (VSSA), U1.AA17 (VSSA), U1.AA19 (VSSA), U1.AA21 (VSSA), U1.AA23 (VSSA), U1.AA25 (VSSA), U1.AA29 (VSSA), U1.AA33 (VSSA), U1.AA37 (VSSA), U1.AA41 (VSSA), U1.AB4 (VSSA), U1.AB6 (VSSA), U1.AB8 (VSSA), U1.AB14 (VSSA), U1.AB20 (VSSA), U1.AB26 (VSSA), U1.AB30 (VSSA), U1.AB32 (VSSA), U1.AB34 (VSSA), U1.AB36 (VSSA), U1.AB38 (VSSA), U1.AB40 (VSSA), U1.AC1 (VSSA), U1.AC3 (VSSA), U1.AC7 (VSSA), U1.AC9 (VSSA), U1.AC11 (VSSA), U1.AC13 (VSSA), U1.AC15 (VSSA), U1.AC17 (VSSA), U1.AC19 (VSSA), U1.AC21 (VSSA), U1.AC23 (VSSA), U1.AC25 (VSSA), U1.AC27 (VSSA), U1.AC29 (VSSA), U1.AC33 (VSSA), U1.AC37 (VSSA), U1.AC41 (VSSA), U1.AD2 (VSSA), U1.AD6 (VSSA), U1.AD12 (VSSA), U1.AD18 (VSSA), U1.AD24 (VSSA), U1.AD30 (VSSA), U1.AD34 (VSSA), U1.AD38 (VSSA), U1.AD42 (VSSA), U1.B2 (VSSA), U1.B4 (VSSA), U1.B8 (VSSA), U1.B12 (VSSA), U1.B16 (VSSA), U1.B20 (VSSA), U1.B22 (AVSS), U1.B32 (AVSS), U1.C5 (VSSA), U1.C7 (VSSA), U1.C9 (VSSA), U1.C11 (VSSA), U1.C13 (VSSA), U1.C15 (VSSA), U1.C17 (VSSA), U1.C19 (VSSA), U1.C31 (AVSS), U1.C41 (AVSS), U1.D24 (AVSS), U1.D26 (AVSS), U1.D28 (AVSS), U1.D36 (AVSS), U1.D38 (AVSS), U1.D40 (AVSS), U1.E31 (AVSS), U1.E33 (AVSS), U1.F24 (VSS), U1.F26 (VSS), U1.F28 (VSS), U1.F30 (VSS), U1.F32 (VSS), U1.F34 (VSS), U1.F36 (VSS), U1.F40 (AVSS), U1.F42 (AVSS), U1.G41 (AVSS), U1.H26 (VSSA), U1.H28 (VSSA), U1.H30 (VSSA), U1.H32 (VSSA), U1.H34 (VSSA), U1.H36 (VSSA), U1.H38 (VSSA), U1.K8 (VSSA), U1.K10 (VSSA), U1.K12 (VSSA), U1.K14 (VSSA), U1.K16 (VSSA), U1.K18 (VSS), U1.K20 (VSS), U1.K38 (VSSA), U1.M10 (VSSA), U1.M12 (VSSA), U1.M14 (VSSA), U1.M16 (VSSA), U1.M18 (VSS), U1.M20 (VSS), U1.P10 (VSS), U1.P12 (VSS), U1.P14 (VSS), U1.P16 (VSS), U1.P18 (VSS), U1.P20 (VSS), U1.R35 (VSS), U1.T10 (VSS), U1.T12 (VSS), U1.T14 (VSS), U1.T16 (VSS), U1.T18 (VSS), U1.T20 (VSS), U1.U1 (VSS_SVR), U1.V12 (VSSA), U1.V14 (VSSA), U1.V16 (VSSA), U1.V18 (VSSA), U1.V20 (VSSA), U1.W3 (RSVDW3_VSS), U1.W29 (VSSA), U1.W31 (VSSA), U1.W33 (VSSA), U1.W35 (VSSA), U1.W37 (VSSA), U1.W39 (VSSA), U1.Y2 (VSS_S), U1.Y4 (VSSA), U1.Y6 (VSSA), U1.Y8 (VSSA), U1.Y14 (VSSA), U1.Y26 (VSSA), U1.Y28 (VSSA), U1.Y32 (VSSA), U1.Y36 (VSSA), U1.Y40 (VSSA)
unnamed: L2.1, U1.V2 (SVR_IND)
P0_AVDDL: U1.C33 (P0_AVDDL), U1.C35 (P0_AVDDL), U1.C37 (P0_AVDDL), U1.C39 (P0_AVDDL)
P1_AVDDL: U1.C23 (P1_AVDDL), U1.C25 (P1_AVDDL), U1.C27 (P1_AVDDL), U1.C29 (P1_AVDDL)
PLL_VDD: U1.G39 (PLL_VDD)
VCCA: C13.2, C14.2, C15.2, C16.2, L2.2, U1.L11 (VCCA), U1.L13 (VCCA), U1.L15 (VCCA), U1.L17 (VCCA), U1.N11 (VCCA), U1.N13 (VCCA), U1.N15 (VCCA), U1.W13 (VCCA), U1.W15 (VCCA), U1.W17 (VCCA), U1.W19 (VCCA), U1.W21 (VCCA)
VCCD: U1.L19 (VCCD), U1.L21 (VCCD), U1.N17 (VCCD), U1.N19 (VCCD), U1.N21 (VCCD), U1.R13 (VCCD), U1.R15 (VCCD), U1.R17 (VCCD), U1.R19 (VCCD), U1.R21 (VCCD), U1.T8 (RSVDT8_VCCD), U1.U11 (VCCD), U1.U13 (VCCD), U1.U15 (VCCD), U1.U17 (VCCD), U1.U19 (VCCD), U1.W9 (VCCD_A)
XFI_PVDD: U1.J33 (XFI_PVDD)
XFI_VDD: U1.J27 (XFI_VDD), U1.J29 (XFI_VDD), U1.J31 (XFI_VDD), U1.J35 (XFI_VDD)
XGB_AVDDH: U1.D34 (XGB_AVDDH)
