antmicro/oculink-10gbe-adapter/x710-at2-rsvd.kicad_sch

## KiCad design x710-at2-rsvd.kicad_sch (2026-02-23, an earlier design)

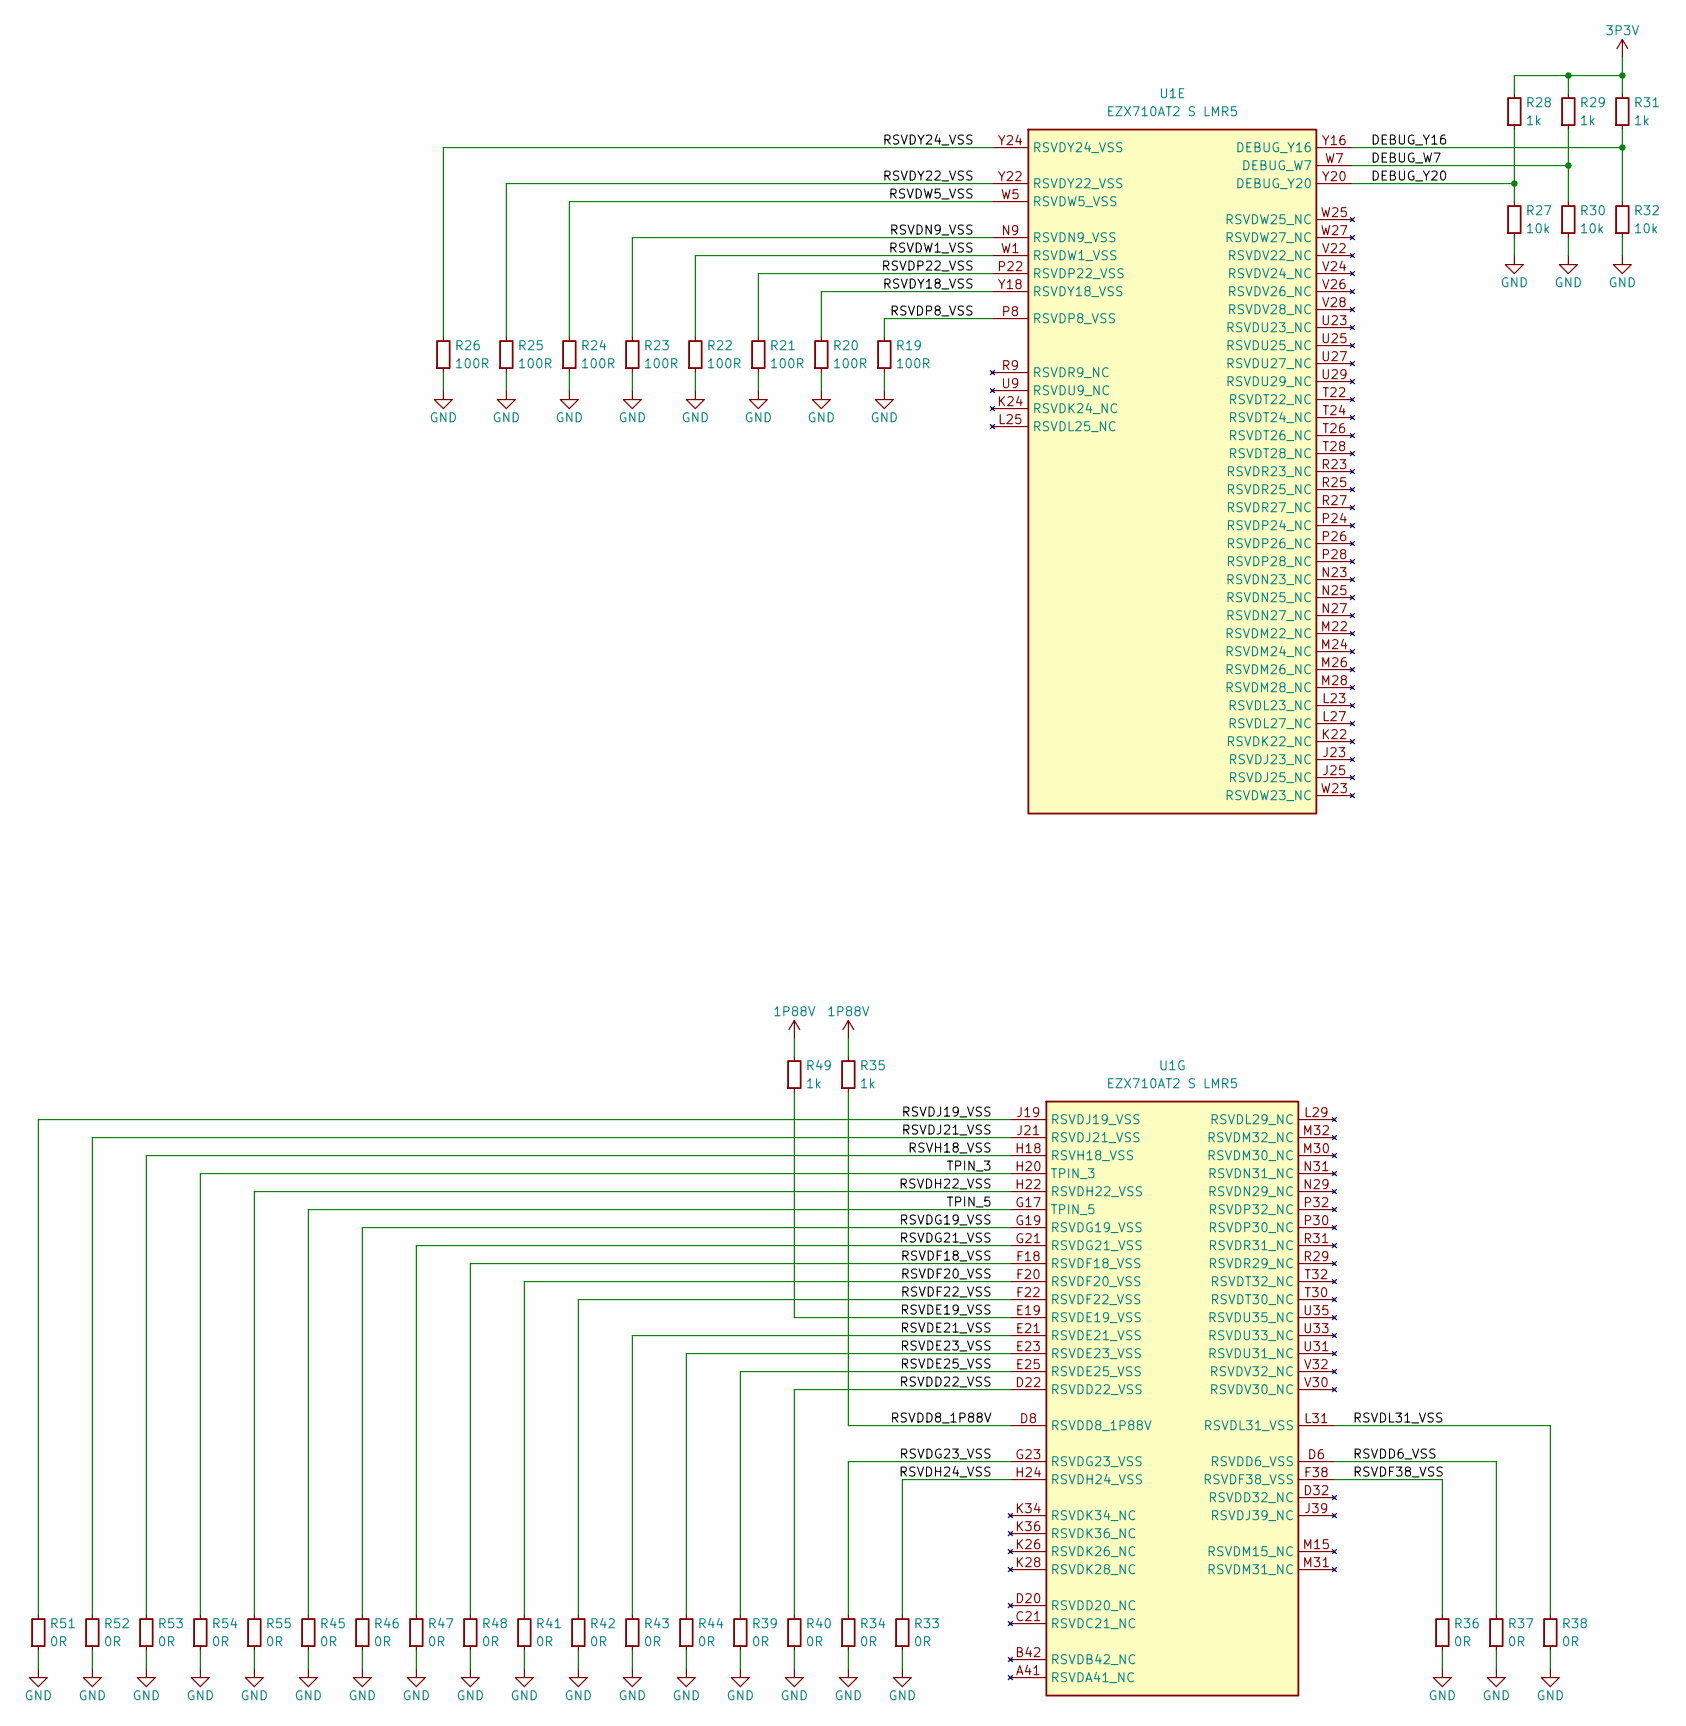
[picture p11: schematic x710-at2-rsvd.kicad_sch]

Parts:
R19, R20, R21, R22, R23, R24, R25, R26: R_100R_0402; R_0402_1005Metric; Tolerance 1%; MPN CR0402-FX-1000GLF
R27, R30, R32: R_10k_0402; R_0402_1005Metric; Tolerance 1%; MPN CR0402-FX-1002GLF
R28, R29, R31, R35, R49: R_1k_0402; R_0402_1005Metric; Tolerance 1%; MPN CR0402-FX-1001GLF
R33, R34, R36, R37, R38, R39, R40, R41, R42, R43, R44, R45, R46, R47, R48, R51, R52, R53, R54, R55: R_0R_0402; R_0402_1005Metric; MPN ERJ2GE0R00X
U1: EZX710AT2_S_LMR5; FCBGA-503_22x22mm_Layout21x24_P1mm; MPN EZX710AT2 S LMR5

Connections:
1P88V: R35.2, R49.2
3P3V: R28.2, R29.2, R31.2
DEBUG_W7: R29.1, R30.2, U1.W7 (DEBUG_W7)
DEBUG_Y16: R31.1, R32.2, U1.Y16 (DEBUG_Y16)
DEBUG_Y20: R27.2, R28.1, U1.Y20 (DEBUG_Y20)
GND: R19.1, R20.1, R21.1, R22.1, R23.1, R24.1, R25.1, R26.1, R27.1, R30.1, R32.1, R33.1, R34.1, R36.1, R37.1, R38.1, R39.1, R40.1, R41.1, R42.1, R43.1, R44.1, R45.1, R46.1, R47.1, R48.1, R51.1, R52.1, R53.1, R54.1, R55.1
RSVDD6_VSS: R37.2, U1.D6 (RSVDD6_VSS)
RSVDD8_1P88V: R35.1, U1.D8 (RSVDD8_1P88V)
RSVDD22_VSS: R40.2, U1.D22 (RSVDD22_VSS)
RSVDE19_VSS: R49.1, U1.E19 (RSVDE19_VSS)
RSVDE21_VSS: R43.2, U1.E21 (RSVDE21_VSS)
RSVDE23_VSS: R44.2, U1.E23 (RSVDE23_VSS)
RSVDE25_VSS: R39.2, U1.E25 (RSVDE25_VSS)
RSVDF18_VSS: R48.2, U1.F18 (RSVDF18_VSS)
RSVDF20_VSS: R41.2, U1.F20 (RSVDF20_VSS)
RSVDF22_VSS: R42.2, U1.F22 (RSVDF22_VSS)
RSVDF38_VSS: R36.2, U1.F38 (RSVDF38_VSS)
RSVDG19_VSS: R46.2, U1.G19 (RSVDG19_VSS)
RSVDG21_VSS: R47.2, U1.G21 (RSVDG21_VSS)
RSVDG23_VSS: R34.2, U1.G23 (RSVDG23_VSS)
RSVDH22_VSS: R55.2, U1.H22 (RSVDH22_VSS)
RSVDH24_VSS: R33.2, U1.H24 (RSVDH24_VSS)
RSVDJ19_VSS: R51.2, U1.J19 (RSVDJ19_VSS)
RSVDJ21_VSS: R52.2, U1.J21 (RSVDJ21_VSS)
RSVDL31_VSS: R38.2, U1.L31 (RSVDL31_VSS)
RSVDN9_VSS: R23.2, U1.N9 (RSVDN9_VSS)
RSVDP8_VSS: R19.2, U1.P8 (RSVDP8_VSS)
RSVDP22_VSS: R21.2, U1.P22 (RSVDP22_VSS)
RSVDW1_VSS: R22.2, U1.W1 (RSVDW1_VSS)
RSVDW5_VSS: R24.2, U1.W5 (RSVDW5_VSS)
RSVDY18_VSS: R20.2, U1.Y18 (RSVDY18_VSS)
RSVDY22_VSS: R25.2, U1.Y22 (RSVDY22_VSS)
RSVDY24_VSS: R26.2, U1.Y24 (RSVDY24_VSS)
RSVH18_VSS: R53.2, U1.H18 (RSVH18_VSS)
TPIN_3: R54.2, U1.H20 (TPIN_3)
TPIN_5: R45.2, U1.G17 (TPIN_5)
