antmicro/oculink-10gbe-adapter/(commit log)

2025-07-22 [#80813] Init project
    [10-gbe-expansion.kicad_pcb, 10-gbe-expansion.kicad_sch]
2026-01-19 [#80813] Draft X710 power, PCIe and 10GbE interfaces
    [10-gbe-expansion.kicad_pcb, 10-gbe-expansion.kicad_sch, x710-at2-10gbe.kicad_sch, x710-at2-pcie.kicad_sch, x710-at2-power.kicad_sch]
2026-01-19 [#80813] Draft X710 RSVD and misc
    [10-gbe-expansion.kicad_sch, x710-at2-mics.kicad_sch, x710-at2-rsvd.kicad_sch]
2026-01-19 [#80813] Add RJ45 connectors, add SMBus, FLASH SPI and misc
    [10-gbe-expansion.kicad_sch, 2xrj45.kicad_sch, flash-memory.kicad_sch, x710-at2-10gbe.kicad_sch, x710-at2-mics.kicad_sch, x710-at2-pcie.kicad_sch, x710-at2-power.kicad_sch, x710-at2-rsvd.kicad_sch]
2026-01-19 [#80813] Add NCSI bus
    [10-gbe-expansion.kicad_sch, x710-at2-mics.kicad_sch]
2026-01-19 [#80813] Add power supply sheet, reorder schematic hierarchy
    [10-gbe-expansion.kicad_sch, power.kicad_sch]
2026-01-19 [#80813] Add misc, improve schematic readability
    [10-gbe-expansion.kicad_sch, misc.kicad_sch, x710-at2-10gbe.kicad_sch, x710-at2-mics.kicad_sch, x710-at2-pcie.kicad_sch, x710-at2-power.kicad_sch]
2026-01-19 [#80813] Change RJ45 connectors, reannotate schematics
    [10-gbe-expansion.kicad_sch, 2xrj45.kicad_sch, flash-memory.kicad_sch, misc.kicad_sch, x710-at2-10gbe.kicad_sch, x710-at2-mics.kicad_sch, x710-at2-pcie.kicad_sch, x710-at2-power.kicad_sch]
2026-01-19 [#80813] Improve schematic readability, add debug connectors and missing resistors
    [10-gbe-expansion.kicad_sch, 2xrj45.kicad_sch, misc.kicad_sch, power.kicad_sch, x710-at2-10gbe.kicad_sch, x710-at2-mics.kicad_sch, x710-at2-pcie.kicad_sch, x710-at2-power.kicad_sch]
2026-01-19 [#80813] WIP: Add decoupling capacitors
    [x710-at2-power.kicad_sch]
2026-01-19 [#80813] Change 3V3 and 1V88 power rails names
    [10-gbe-expansion.kicad_sch, 2xrj45.kicad_sch, flash-memory.kicad_sch, misc.kicad_sch, x710-at2-10gbe.kicad_sch, x710-at2-mics.kicad_sch, x710-at2-pcie.kicad_sch, x710-at2-power.kicad_sch]
2026-01-19 [#80813] WIP: Adjust passives values, add missing load capacitors for the 50MHz resonator
    [2xrj45.kicad_sch, flash-memory.kicad_sch, misc.kicad_sch, x710-at2-10gbe.kicad_sch, x710-at2-pcie.kicad_sch, x710-at2-power.kicad_sch, x710-at2-rsvd.kicad_sch]
2026-01-19 [#80813] Adjust passives values, add remaining decoupling capacitors
    [2xrj45.kicad_sch, misc.kicad_sch, power.kicad_sch, x710-at2-10gbe.kicad_sch, x710-at2-mics.kicad_sch, x710-at2-pcie.kicad_sch, x710-at2-power.kicad_sch, x710-at2-rsvd.kicad_sch]
2026-01-19 [#80813] WIP: Add power supply section
    [power.kicad_sch, x710-at2-10gbe.kicad_sch, x710-at2-pcie.kicad_sch, x710-at2-power.kicad_sch]
2026-01-19 [#80813] WIP: Add DC-DC converters placeholders with power rail specifications
    [power.kicad_sch]
2026-01-19 [#80813] Add OCuLink connector
    [10-gbe-expansion.kicad_sch, 2xrj45.kicad_sch, flash-memory.kicad_sch, misc.kicad_sch, oculink.kicad_sch, power.kicad_sch, x710-at2-10gbe.kicad_sch, x710-at2-mics.kicad_sch]
2026-01-19 [#80813] Add power input connectors, heatsink, mounting, draft component placement
    [10-gbe-expansion.kicad_sch, 2xrj45.kicad_sch, misc.kicad_sch, power.kicad_sch, x710-at2-10gbe.kicad_sch, x710-at2-mics.kicad_sch, x710-at2-pcie.kicad_sch, x710-at2-power.kicad_sch]
2026-01-19 [#80813] WIP: Connect USB-C connector
    [power.kicad_sch]
2026-01-19 [#80813] Add power ORing
    [10-gbe-expansion.kicad_sch, ideal-diode.kicad_sch, power.kicad_sch]
2026-01-19 [#80813] Change PCB mounts, replace NCSI connector with testpoints
    [10-gbe-expansion.kicad_sch, 2xrj45.kicad_sch, misc.kicad_sch, x710-at2-mics.kicad_sch]
2026-01-19 [#80813] Remove OCuLink power pins connections
    [10-gbe-expansion.kicad_sch, ideal-diode.kicad_sch, oculink.kicad_sch, power.kicad_sch, x710-at2-10gbe.kicad_sch]
2026-01-19 [#80813] Change inductors, minor PCB changes
    [flash-memory.kicad_sch, oculink.kicad_sch, power.kicad_sch, x710-at2-power.kicad_sch]
2026-01-19 [#81595] Update symbols from library
    [10-gbe-expansion.kicad_sch, 2xrj45.kicad_sch, flash-memory.kicad_sch, ideal-diode.kicad_sch, misc.kicad_sch, oculink.kicad_sch, power.kicad_sch, x710-at2-10gbe.kicad_sch]
2026-01-19 [#81595] Create DC-DC converters schematic section
    [power.kicad_sch]
2026-01-19 [#81595] Fix bus input/output types
    [10-gbe-expansion.kicad_sch, 2xrj45.kicad_sch, oculink.kicad_sch, x710-at2-10gbe.kicad_sch, x710-at2-pcie.kicad_sch]
2026-01-19 [#81595] WIP: Connect remaining control signals
    [power.kicad_sch, x710-at2-mics.kicad_sch]
2026-01-19 [#85196] WIP: Add power sequencing, connect CPRSNT signal
    [10-gbe-expansion.kicad_sch, oculink.kicad_sch, power.kicad_sch]
2026-01-19 [#85196] Draft DC-DC converters with new IC
    [power.kicad_sch]
2026-01-19 [#85196] Finish design of all power rails DC-DC converters
    [power.kicad_sch]
2026-01-19 [#85196] Fix 1V0 and DVDD sequencing
    [power.kicad_sch]
2026-01-19 [#85196] Update PCB from schematic, remove second heat sink
    [10-gbe-expansion.kicad_sch, x710-at2-power.kicad_sch]
2026-01-19 [#85196] Clear ERC, minor schematic fixes
    [2xrj45.kicad_sch, flash-memory.kicad_sch, oculink.kicad_sch, power.kicad_sch, x710-at2-10gbe.kicad_sch, x710-at2-mics.kicad_sch, x710-at2-pcie.kicad_sch, x710-at2-power.kicad_sch]
2026-01-19 [#85196] Fix bootstrap capacitor connections
    [power.kicad_sch]
2026-01-19 [#85196] Change 2u2 inductor, minor schematic cleanup
    [misc.kicad_sch, power.kicad_sch]
2026-01-19 [#85196] Re-annotate schematic
    [10-gbe-expansion.kicad_sch, 2xrj45.kicad_sch, flash-memory.kicad_sch, ideal-diode.kicad_sch, misc.kicad_sch, oculink.kicad_sch, power.kicad_sch, x710-at2-10gbe.kicad_sch]
2026-01-19 [#86617] Fix malformed DNP components
    [oculink.kicad_sch, power.kicad_sch]
2026-01-19 [#86617] Update date in the Title Block
    [10-gbe-expansion.kicad_sch, 2xrj45.kicad_sch, flash-memory.kicad_sch, ideal-diode.kicad_sch, misc.kicad_sch, oculink.kicad_sch, power.kicad_sch, x710-at2-10gbe.kicad_sch]
2026-01-19 [#86617] Fix ATS-61500R-C2-R0 fields visibilities
    [10-gbe-expansion.kicad_sch]
2026-01-19 [#86617] Unify captions, add TVS to USB VBUS
    [flash-memory.kicad_sch, ideal-diode.kicad_sch, oculink.kicad_sch, power.kicad_sch]
2026-01-19 [#86617] Add PWR test-points and PGOOD LED, fix MAIN_PWR_OK voltage level
    [10-gbe-expansion.kicad_sch, power.kicad_sch, x710-at2-mics.kicad_sch]
2026-01-19 [#86617] Power U10 from OCuLink, remove JTAG sheet pin, fix I2C cross
    [misc.kicad_sch, oculink.kicad_sch, x710-at2-10gbe.kicad_sch, x710-at2-mics.kicad_sch, x710-at2-pcie.kicad_sch]
2026-01-19 [#86617] Remove misc schematic sheet
    [10-gbe-expansion.kicad_sch, misc.kicad_sch, x710-at2-10gbe.kicad_sch, x710-at2-mics.kicad_sch]
2026-01-19 [#86617] Add more capacitance to DC-DC converters outputs
    [power.kicad_sch]
2026-01-19 [#86617] Add Tag-Connect to flash memory
    [flash-memory.kicad_sch]
2026-01-19 [#86351] Update PCB from schematic, setup design rules
2026-01-19 [#86351] Rename project
    [10-gbe-expansion.kicad_sch, 2xrj45.kicad_sch, flash-memory.kicad_sch, ideal-diode.kicad_sch, oculink-to-10gbe-adapter.kicad_sch, oculink.kicad_sch, power.kicad_sch, x710-at2-10gbe.kicad_sch]
2026-01-19 [#86617] Change debug EN jumper to a switch
    [x710-at2-rsvd.kicad_sch]
2026-01-19 [#86351] Update PCB from schematic
2026-01-19 [#86617] Change flash memory to AT25DF641A-SH
    [flash-memory.kicad_sch]
2026-01-19 [#86351] Remove components outside board outline, add logos
2026-01-19 [#86851] Add fan controller
    [fan-controller.kicad_sch, oculink-to-10gbe-adapter.kicad_sch, power.kicad_sch]
2026-01-19 [#86851] Add option to set the fan supply to 5V, minor schematic readability improvement
    [fan-controller.kicad_sch]
2026-01-19 [#86351] Connect Tag Connect 3V3 pin, clear ERC
    [flash-memory.kicad_sch, oculink-to-10gbe-adapter.kicad_sch, oculink.kicad_sch, power.kicad_sch, x710-at2-10gbe.kicad_sch]
2026-01-19 [#86351] WIP: Layout power
2026-01-19 [#86351] Layout power planes from X710 IC, change 4u7 inductor to one with smaller resistance
    [x710-at2-power.kicad_sch]
2026-01-19 [#86351] WIP: Layout flash memory
    [x710-at2-mics.kicad_sch]
2026-01-19 [#86351] Replace RSVD_VSS 0Rs with direct connection
    [x710-at2-mics.kicad_sch, x710-at2-rsvd.kicad_sch]
2026-01-19 [#86351] WIP: Passives component placement
    [oculink.kicad_sch, x710-at2-rsvd.kicad_sch]
2026-01-19 [#86351] Layout OCuLink connector
2026-01-19 [#86351] Rearrange power section
2026-01-19 [#86351] Layout DC-DC converters power planes, clean up Fab layers
2026-01-19 [#86351] Temporarily remove components designators from silkscreen
2026-01-19 Update PCB render in README
2026-01-19 [#86351] Continue layout
    [flash-memory.kicad_sch, x710-at2-mics.kicad_sch]
2026-01-19 [#86351] Minor BOM consolidation
    [2xrj45.kicad_sch, flash-memory.kicad_sch, power.kicad_sch, x710-at2-10gbe.kicad_sch, x710-at2-mics.kicad_sch, x710-at2-power.kicad_sch]
2026-01-19 [#88407] WIP: Layout power and low speed signals
2026-01-19 [#88407] WIP: Layout power
2026-01-19 [#88407] Unhide component designators on silkscreen
2026-01-19 [#88407] Reposition power connectors and debug switch
2026-01-19 [#88407] Minor layout improvements in power section and misc signals
2026-01-19 [#88407] Add mounting holes with copper for the heat sink mounting screws
    [oculink-to-10gbe-adapter.kicad_sch]
2026-01-19 [#88407] Fix heat sink mounting holes, add via stitching
2026-01-19 [#88407] Optimize power planes; kmake dnp, sync with lib
2026-01-19 [#88407] Sch: Add PCIe ref clock; Add ICT testpoints; Add fan TVS
    [2xrj45.kicad_sch, fan-controller.kicad_sch, flash-memory.kicad_sch, ideal-diode.kicad_sch, oculink-to-10gbe-adapter.kicad_sch, oculink.kicad_sch, power.kicad_sch, x710-at2-10gbe.kicad_sch]
2026-01-19 [#88407] PCB: Add PCIe cutouts; Add PCIe clock gen; HS tuning
    [fan-controller.kicad_sch, oculink-to-10gbe-adapter.kicad_sch, power.kicad_sch, x710-at2-10gbe.kicad_sch, x710-at2-pcie.kicad_sch, x710-at2-power.kicad_sch]
2026-01-19 [#88407] PCB: Connect ICT testpoints, Improve clock & dcdc layouts
2026-01-19 [#88407] PCB: Clean silkscreen
    [fan-controller.kicad_sch, flash-memory.kicad_sch, oculink-to-10gbe-adapter.kicad_sch, power.kicad_sch, x710-at2-10gbe.kicad_sch, x710-at2-pcie.kicad_sch, x710-at2-power.kicad_sch]
2026-01-19 [#88407] Fix PCIe CLK section impedance, minor silkscreen cleanup
2026-01-19 [#88407] Update date on SCH and PCB, fix 10k NTC footprint, change from 0603 to 0402
    [2xrj45.kicad_sch, fan-controller.kicad_sch, flash-memory.kicad_sch, ideal-diode.kicad_sch, oculink-to-10gbe-adapter.kicad_sch, oculink.kicad_sch, power.kicad_sch, x710-at2-10gbe.kicad_sch]
2026-01-19 [#88407] Extend USB-C and OCuLink connectors outside the PCB outline
2026-01-19 [#89038] Fix 5p6 capacitor
    [x710-at2-mics.kicad_sch]
2026-01-19 [#89038] Improve GND cutout
2026-01-19 [#89038] Add OCuLink 3V3 indicator LED, add polarity marking for DC connector
    [oculink.kicad_sch]
2026-01-19 [#89038] Add ETH and FAN connector labels
2026-01-19 [#89038] Add power test points for ICT
    [power.kicad_sch]
2026-01-19 [#89038] Add power indicator LEDs, reroute FLASH MISO signal
    [power.kicad_sch]
2026-01-19 [#89038] Move top power test points near power indicator LEDs, set heat sink mounting holes copper layers to top, bottom and connected layers
2026-01-19 [#89038] Update project date
    [2xrj45.kicad_sch, fan-controller.kicad_sch, flash-memory.kicad_sch, ideal-diode.kicad_sch, oculink-to-10gbe-adapter.kicad_sch, oculink.kicad_sch, power.kicad_sch, x710-at2-10gbe.kicad_sch]
2026-01-19 [#89038] Update pcb render
2026-01-19 [#89038] Rotate FAN label
2026-01-19 Set heatsink and fan controller section as DNP
    [oculink-to-10gbe-adapter.kicad_sch]
2026-01-19 Update PCB render
2026-02-03 Draw board outline with lines instead of rectangle
2026-02-19 [#91871] Connect power indicator LEDs to +3V3_OUT
    [power.kicad_sch]
2026-02-23 [#91871] Fix not working ETH PHY - add 10pF capacitors to MDIO
    [x710-at2-10gbe.kicad_sch]
2026-02-23 [#91871] Change LEDs resistors from 10k to 1k, minor BOM consolidation
    [fan-controller.kicad_sch, oculink.kicad_sch, power.kicad_sch]
2026-02-23 [#91871] Change 3V3 DC-DC converter feedback resisors to more common values
    [power.kicad_sch]
2026-02-23 [#91871] Add pull-up resistor to !PHY_RESET
    [x710-at2-mics.kicad_sch]
2026-02-23 [#91871] Change !PE_RST buffor IC power from +3V3_AUX to +3V3
    [x710-at2-mics.kicad_sch]
2026-02-23 [#91871] Bump to rev.1.1.0, update date
    [2xrj45.kicad_sch, fan-controller.kicad_sch, flash-memory.kicad_sch, ideal-diode.kicad_sch, oculink-to-10gbe-adapter.kicad_sch, oculink.kicad_sch, power.kicad_sch, x710-at2-10gbe.kicad_sch]
2026-02-24 [#91871] Clear DRC and ERC
    [ideal-diode.kicad_sch, power.kicad_sch]
2026-02-24 README: Update PCB render
